alextomdog/3d-printer/docs/design.md

# 设计说明

## 1. 总体方案

这是一台 Cartesian 结构 FDM 打印机：X/Y 轴在水平面内运动，Z 轴带动热床升降。设计目标是使用 1515 铝型材、市售标准件和少量铝加工件，完成一台 220 × 220 mm 打印幅面的桌面机。

坐标定义沿用 BOM 中的约定：

- X：同一平面内两台 XY 步进电机连线的方向
- Y：同一平面内与 X 垂直的方向
- Z：垂直于水平面的方向

## 2. 框架

框架由 1515 铝型材组成：

| 长度 | 数量 | 位置 |
|---|---|---|
| 320 mm | 4 | Z 方向垂直支撑 |
| 285 mm | 4 | X 方向水平支撑 |
| 293 mm | 4 | Y 方向水平支撑 |
| 220 mm | 2 | 托盘 X 方向水平支撑 |
| 200 mm | 2 | 托盘 Y 方向水平支撑 |

型材之间用直角脚槽连接，配合 1515 T 型螺母与 M3 螺丝固定。框架的矩形度由 285/293 mm 两组横梁和角件共同保证。

## 3. XY 传动

- 动力：2 台 42-44 步进电机。
- 同步带：GT2-6，带宽 6 mm。
- 同步轮：2GT-20 齿、内孔 5 mm；主动轮 2 个，惰轮带齿 8 个、不带齿 2 个。
- 导向：MGN9 导轨，278 mm × 1 用于喷头移动，250 mm × 2 用于交叉方向；MGN9 标准滑块 3 个。

同步带轮固定在步进电机轴上，惰轮用于支撑和张紧皮带。喷头组件安装在 MGN9 滑块上，由 X 向同步带驱动。

## 4. 双 Z 与热床

- 动力：2 台 42-38 步进电机。
- 传动：T8 250 mm 丝杠 × 4，T8 法兰螺母 × 4；M5 转 M8 联轴器 × 2。
- 导向：M6 × 265 mm 光轴 × 4，SCS6UU 箱式滑块 × 4。
- 热床：MK3 铝基板热床 220 × 220 mm，200 × 200 mm 玻璃板，四角弹簧 + M3 螺丝调平。
- 测温：NTC 温度传感器。

双 Z 电机分别驱动左右丝杠，光轴与 SCS6UU 滑块承担侧向载荷。热床四边固定件与底部框架连接件把热床组件约束在 Z 托架上。

## 5. 挤出与喷头

- 热端：E3D V6 远程挤出头，1.75 mm 耗材、0.4 mm 喷嘴、12 V 40 W。
- 挤出机：MK8 远程挤出机，42-47 步进电机驱动。
- 安装：3D 打印 42 步进电机固定片、EV3 挤出头散热器固定块、火山喷头 V6 装配体。
- 导向：喷头安装在 MGN9 278 mm 导轨滑块上，配喷头限位器固定件与水平限位开关固定器。

## 6. 电控

- 主板：RAMPS 1.4 + Arduino Mega 2560。
- 驱动：5 × A4988，分别对应 X、Y、Z1、Z2、挤出机。
- 显示：2004 LCD。
- 电源：12 V 9 A。
- 传感器：NTC 热敏、X/Y/Z 限位开关。
- 热床与热端：MK3 热床、E3D V6 加热棒与风扇。

电气连接示意见 [`system-diagram.md`](system-diagram.md)。仓库不包含固件与引脚配置。

## 7. 加工与装配

- 15 张 DWG 加工图位于 `new_sw/cadFiles/`，覆盖框架连接件、热床固定件、同步带卡件、挤出机支架等。
- 铝加工件由外协加工，其余多为 3D 打印件或市售标准件。
- 主装配体为 `new_sw/打印机.SLDASM`；子装配体包括 `z-axis-with-slider.SLDASM`、`z-step-motor-conbination.SLDASM`、`火山喷头V6.SLDASM`、`MK8 Red Extruder Bowden.SLDASM` 等。

## 8. 设计边界

本项目完成结构、零件、装配、加工图与 BOM，不包含：

- Marlin 固件、引脚定义、PID/步进校准
- 切片参数、材料参数、打印测试
- 实物照片、装配视频、长期运行数据

因此仓库中的模型与图纸可用于复现结构设计，但不能直接证明整机已经制造或达到某个打印精度。
