alextomdog/3d-printer/THIRD_PARTY.md

# Third-Party Notices

本仓库的原创 CAD 模型、DWG 图纸、BOM 与文档采用 CERN-OHL-S-2.0（见 `LICENSE`）。以下标准件/厂商模型仅用于装配参考，版权归各自所有者，**不在本项目许可证覆盖范围内**：

| 名称 | 说明 |
|---|---|
| E3D V6 | 热端/喷头模型与规格，E3D 为其所有者 |
| MK8 Extruder | 挤出机模型，版权归原厂商 |
| MGN9 | 直线导轨与滑块，HIWIN 及相关厂商为其所有者 |
| RAMPS 1.4 | 开源硬件扩展板设计，版权归原作者 |
| A4988 | 步进驱动模块，Allegro 及相关厂商为其所有者 |
| Arduino Mega 2560 | 开发板，Arduino 为其所有者 |
| 42 步进电机 | 标准步进电机模型，版权归原厂商 |
| SCS6UU / 光轴 / T8 丝杠 / GT2 同步带 | 市售标准件，版权归各自厂商 |

本项目与上述厂商无隶属或背书关系。若你是权利人并认为某个模型不应出现在本仓库，请提交 issue，我们会移除相关文件。
