alextomdog/3d-printer/docs/bom.md

# BOM 摘要

原始 BOM 见仓库根目录 `material.xlsx` / `material.ods`。下表按功能分类整理规格与数量，**不包含采购价格、运费和商家信息**。

> 数量列保留 BOM 中的采购/备用量；部分紧固件按整包购买，实际装机数量小于采购数量。

## 1. 框架

| 物料 | 规格 | 数量 | 用途 |
|---|---|---|---|
| 1515 铝型材 | 320 mm | 4 | Z 方向垂直支撑 |
| 1515 铝型材 | 285 mm | 4 | X 方向水平支撑 |
| 1515 铝型材 | 293 mm | 4 | Y 方向水平支撑 |
| 1515 铝型材 | 220 mm | 2 | 托盘 X 方向水平支撑 |
| 1515 铝型材 | 200 mm | 2 | 托盘 Y 方向水平支撑 |
| 直角脚槽 | 1515 用 | 8 | 型材连接 |
| 1515 T 型螺母 | M3 | 100 | 型材固定 |

## 2. XY 传动与导向

| 物料 | 规格 | 数量 | 用途 |
|---|---|---|---|
| 42 步进电机 | 机身 44 mm | 2 | X/Y 轴驱动 |
| GT2-6 橡胶皮带 | 宽 6 mm，长 5 m | 1 | XY 传动 |
| 2GT-20 同步轮 | 20 齿，内孔 5 mm，带宽 6 mm | 2 | 电机与皮带连接 |
| 2GT-20 惰轮（带齿） | 20 齿，内孔 5 mm，带宽 6 mm | 8 | 皮带支撑/张紧 |
| 2GT-20 惰轮（不带齿） | 20 齿，内孔 5 mm，带宽 6 mm | 2 | 皮带支撑/张紧 |
| MGN9 导轨 | 278 mm | 1 | 喷头移动导向 |
| MGN9 导轨 | 250 mm | 2 | 交叉方向导向 |
| MGN9 标准滑块 | — | 3 | 配合导轨 |

## 3. Z 轴与热床

| 物料 | 规格 | 数量 | 用途 |
|---|---|---|---|
| 42 步进电机 | 机身 38 mm | 2 | 双 Z 驱动 |
| T8 丝杠 | 250 mm | 4 | Z 轴传动 |
| T8 丝杠法兰螺母 | 内径 8 mm | 4 | 丝杠螺母 |
| 联轴器 | M5 转 M8 | 2 | Z 电机与丝杠连接 |
| 光轴 | M6 × 265 mm | 4 | Z 轴导向 |
| SCS6UU 箱式滑块 | 内径 6 mm | 4 | 光轴滑动 |
| MK3 铝基板热床 | 220 × 220 mm | 1 | 加热平台 |
| 玻璃板 | 200 × 200 mm | 1 | 打印面 |
| 热床弹簧 | — | 4 | 四角调平 |
| NTC 温度传感器 | — | 1 | 热床测温 |
| 高温胶带 | — | 1 | 热床绝缘/固定 |

## 4. 挤出与喷头

| 物料 | 规格 | 数量 | 用途 |
|---|---|---|---|
| 42 步进电机 | 机身 47 mm | 1 | 挤出机驱动 |
| E3D V6 远程挤出头 | 1.75 mm / 0.4 mm，12 V 40 W | 1 | 熔融挤出 |
| MK8 挤出机 | — | 1 | 耗材输送 |
| 3D 打印 42 步进电机固定片 | — | 1 | 卧式固定挤出机 |
| EV3 挤出头散热器固定块 | — | 1 | 固定远程挤出头 |
| 火山喷头 V6 装配体 | — | 1 | 喷头组件 |

## 5. 电控

| 物料 | 规格 | 数量 | 用途 |
|---|---|---|---|
| RAMPS 1.4 扩展板 | Mega 2560 接口 | 1 | 步进电机与外围接口 |
| Arduino Mega 2560 | — | 1 | 主控 |
| A4988 步进驱动模块 | 红色 | 5 | X/Y/Z1/Z2/E 驱动 |
| 2004 LCD | — | 1 | 状态显示与控制 |
| 12 V 9 A 电源 | 实测约 12.4 V / 9.3 A | 1 | 整机供电 |
| 限位开关 | — | 3 | X/Y/Z 回零 |

## 6. 紧固件与加工件

| 物料 | 规格 | 数量 | 用途 |
|---|---|---|---|
| M3 × 6 螺丝 | — | 150（采购量） | 框架/零件固定 |
| M3 × 18 螺丝 | — | 50（采购量） | 升降台固定 |
| M3 × 15 螺丝 | — | 50（采购量） | 火山喷头铝片固定 |
| M3 × 35 螺丝 | — | 50（采购量） | 火山喷头下部固定 |
| M5 × 45 螺丝 | — | 20（采购量） | 同步轮固定 |
| M3 螺母 | — | 100（采购量） | 紧固 |
| M5 螺母 | — | 100（采购量） | 紧固 |
| M5 × 10 × 1 垫片 | — | 100（采购量） | 紧固 |
| M3 × 8 × 0.5 垫片 | — | 100（采购量） | 紧固 |
| 铝加工零件 | 按 DWG 加工 | 1 批 | 框架连接、热床固定、同步带卡件、挤出机支架等 |

## 7. 图纸

`new_sw/cadFiles/` 下共 15 张 DWG，主要包括：

- 42 步进电机固定片（XY）
- 侧板、顶板、底板、总装图
- Z 光轴固定
- 同步带卡住零件
- 挤出机支架固定片
- 法兰螺母-热床连接
- 滑动连接器 XY
- 热床四边固定
- 热床底部框架连接
- 边角固定
- 边角支架固定 H 型惰轮
