alextomdog/3d-printer/material.ods

材料 | 数量 | 作用 | 购买价格 | 备注 | 定义X方向为在同一平面内，两个步进电机连线的方向
1515铝型材 | 长320mm x 4 | 作为4个z轴方向上的垂直支撑 | 48 | 运费15 | 定义y方向为在同一平面内，两个步进电机连线的方向的垂直的方向
1515铝型材 | 长285mm x 4 | 作为4个x轴方向上的水平支撑 |  |  | 定义z方向为垂直于水平面的方向
1515铝型材 | 长293mm x 4 | 作为4个y轴方向上的水平支撑
1515铝型材 | 长220mm x 2 | 作为2个x轴方向上的托盘水平支撑 |  |  | 726.54
1515铝型材 | 长200mm x 2 | 作为2个y轴方向上的托盘水平支撑
光轴 | M6长265mm x 4 | 作为运动体系的滑动支撑（z轴） | 16.8
联轴器5转8 | （M5转M8）x 2 | 用来连接z轴方向上步进电机（M5）和丝杠（M8） | 5.44
T8型螺杆（丝杠） | 长250mm x 4 | 通过步进电机用来控制托盘z轴方向的运动 | 32.87
T8丝杠法兰螺母 | 内径8mm x 4 | 作为T8型丝杠的螺母
42步进电机 | （身长47）x 1 | 用来作为高速打印挤出机（挤出打印材料） | 76.3
42步进电机 | （身长44）x 2 | 用来控制xy轴方向上的移动
42步进电机 | （身长38）x 2 | 作为双z轴，用来控制z轴方向上的移动
12V9A电源 | x 1（实际12.4V9.3A12.3欧） | 用来给整台机器供电 | 16.8
scs6uu箱式滑块 | X 4 | z轴光轴滑动固定 | 18.22
GT2-6橡胶皮带 | （长度5m，皮带厚6mm）x 1 | 用来作为传动装置 | 14.51
2GT-20齿内孔5mm同步轮 | （皮带带6mm20齿内孔5mm）x 2 | 用来作为连接皮带和xy轴步进电机的连接装置 | 6.26
2GT-20齿内孔5mm同步轮（惰轮）带齿 | （20齿内孔5带宽6）带齿 x 8 | 用来辅助支撑皮带传动 | 42.75
2GT-20齿内孔5mm同步轮（惰轮）不带齿 | （20齿内孔5带宽6）不带齿 x 2 | 用来辅助支撑皮带传动
RAMPS 1.4 mega 2560扩展版 | X 1 | 用来扩展arduino mega的接口，连接步进电机 | 16.8
2004液晶控制屏幕 | X 1 | 连接ramps，用来显示数据 | 26.21
A4998步进电机驱动模块 | （红色）x 5 | 驱动步进电机 | 21.5
直角脚槽 | X 8 | 用来连接1515铝框架 | 9.9
Arduino Mega2560 | x1 | 单片机控制电路板 | 0
E3D-v6远程挤出头 | （1.75/0.4MM 12v 40w) x1 | 用于挤出材料 | 19.8
MK8-挤出机 | X 1 | 用于传送材料 | 16.8
3D打印42步进电机固定片 | X 1 | 卧式用来固定挤出机 | 2.7
EV3挤出头散热器固定块 | X 1 | 固定远程挤出头 | 12.87
MGN9滑轨长度278 | X 1 | 用来作为喷出头的移动滑轨 | 68.89
MGN9滑轨长度250 | X 2 | 作为交叉方向的移动滑轨
MGN9标准滑块 | X 3 | 配合滑轨一起使用
铝加工零件 | X 1 | 配合各种零件 | 110
M3*6螺丝 | X 56 + 16 + 24 + 6 + 28 → 150 | 整体框架固定 | 13.4
M3*18螺丝 | X 4 → 50 | 升降台固定 | 5.6
M3 * 15 | X 4 → 50 | 火山喷出头铝片固定 | 4.97
M3 * 35 | X 4 → 50 | 火山喷出头下面固定 | 6
M5 * 45 | X 6 → 20 | 用于同步轮固定 | 5.4
M3螺母 | X 10 → 100 |  | 2.06
1515T型螺母M3 | X 100 | 固定 | 25
M5螺母 | X 100 |  | 4.92
M5 * 10 * 1垫片 | X 100 |  | 4.28
M3 * 8 * 0.5 | X 100 |  | 3.76
3d打印机弹簧 | x4 |  | 7.93
高温胶带 | x1 |  | 4.6
NTC温度传感器 | X 1 |  | 4.3
MK3铝基板热床 | x1 |  | 29.3
玻璃板200x200 | X 1 |  | 12.8
3d设计partdatamanager | X 1 | 零件生成 | 8.8
