alextomdog/3d-printer/new_sw/打印机.SLDASM

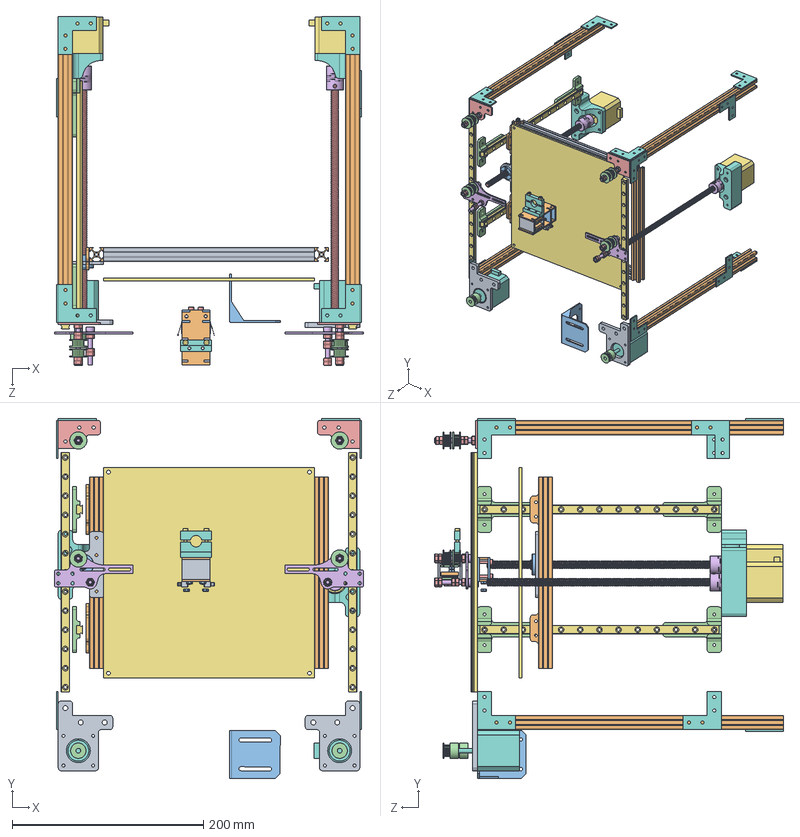
[picture p1: CAD file, 2023-12-28]
new_sw/打印机.SLDASM
323.2 x 376.0 x 365.0 mm
42-步进电机固定片-xy x 2
step-motor-44 x 2
MGN9滑轨 x 4
滑动连接器xy x 2
边角支架固定H型号惰轮 x 2
H型号惰轮20齿带宽6内孔5厚度85带齿 x 8
挤出机固定座支架
E3dV6挤出火山头固定块Ender3系列
GB／T70．1-2000内六角圆柱头螺钉M3×16-火山喷出头 x 2
GB／T70．1-2000内六角圆柱头螺钉M5×35 x 4
M5螺母8-5-3_9 x 24
同步带轮20齿带宽6内孔5厚度85带齿 x 2
bottom2 x 2
asside x 2
top1 x 2
边角固定 x 14
heatedBed热床220x220
GB／T70．1-2000内六角圆柱头螺钉M5×45 x 2
GB／T70．1-2000内六角圆柱头螺钉M3×15 x 4
同步带卡住零件 x 2
M3螺母 x 10
同步带卡住零件 one-side x 2
限位开关 x 2
fixSteperPanel x 2
step-motor-38 x 2
cr-5-8联轴器 x 2
tr8丝杠z轴 x 2
rail_slider_1515_connection x 4
tr8法兰螺母
滑块-热床 x 2
丝杠法兰螺母-热床
