alextomdog/3d-printer/new_sw/vocano/cocano_asemably.SLDASM

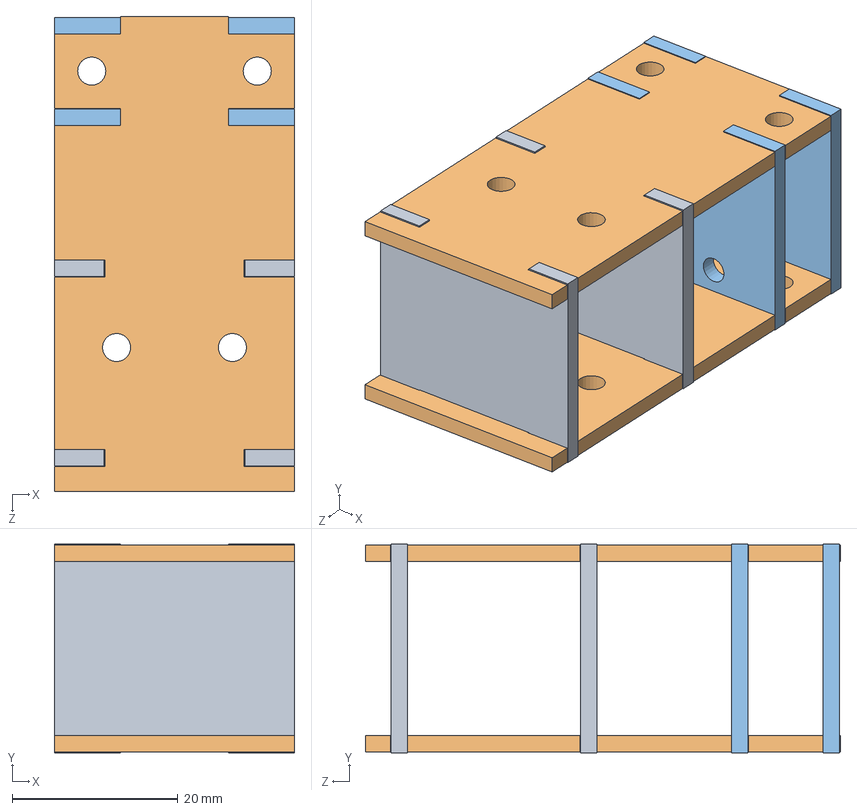
[picture p2: CAD file, 2023-12-27]
new_sw/vocano/cocano_asemably.SLDASM
29.0 x 25.2 x 57.4 mm
bottom2 x 2
asside x 2
top1 x 2
