alextomdog/3d-printer/new_sw/z-axis-with-slider.SLDASM

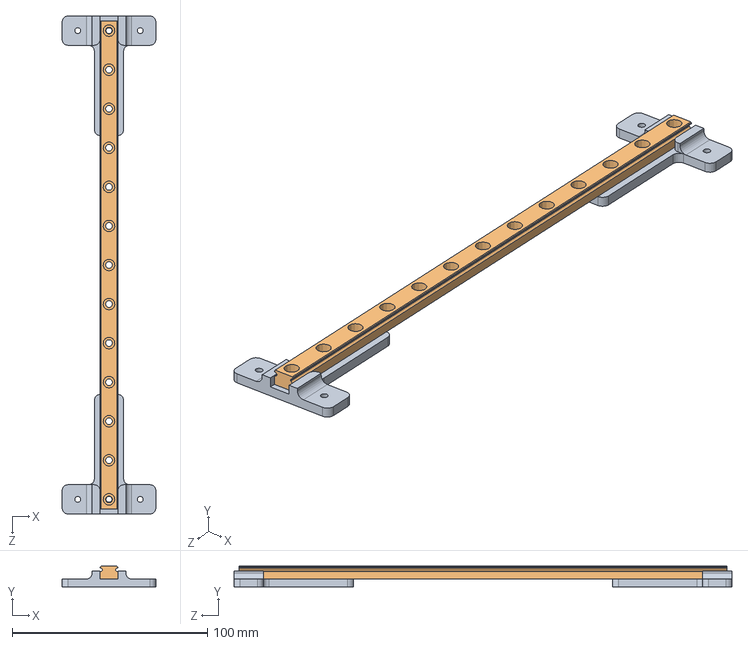
[picture p3: CAD file, 2023-12-28]
new_sw/z-axis-with-slider.SLDASM
48.0 x 10.5 x 255.0 mm
MGN9滑轨
rail_slider_1515_connection x 2
