alextomdog/3d-printer/new_sw/z-step-motor-conbination.SLDASM

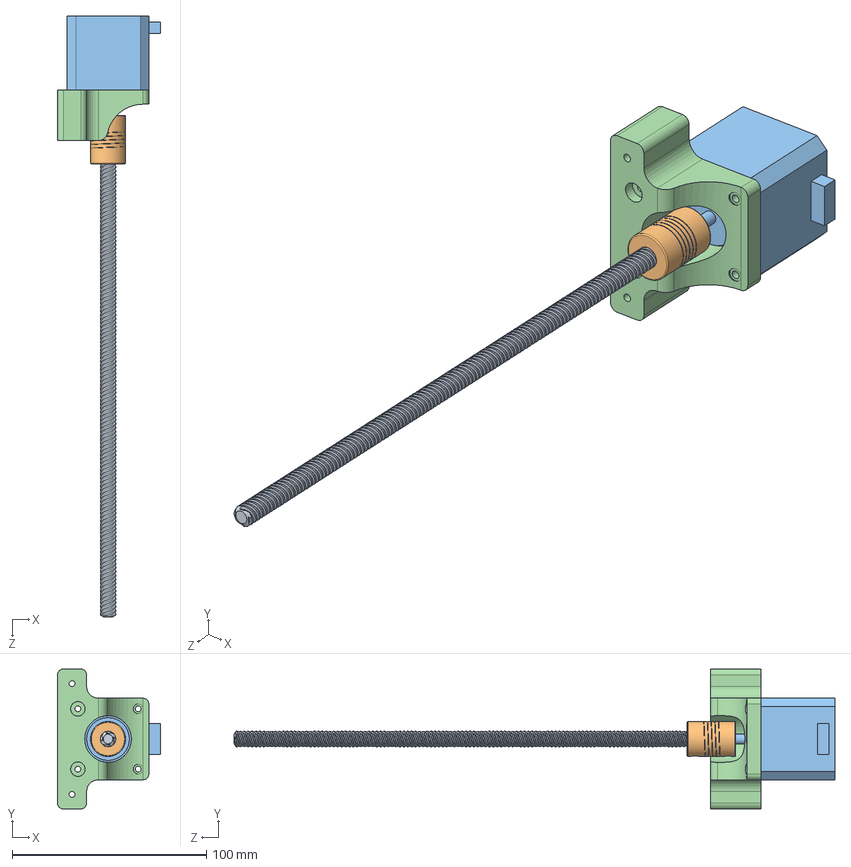
[picture p4: CAD file, 2023-12-27]
new_sw/z-step-motor-conbination.SLDASM
53.0 x 72.0 x 309.0 mm
fixSteperPanel
step-motor-38
cr-5-8联轴器
tr8丝杠z轴
