alextomdog/3d-printer/new_sw/火山喷头限位开关固定装配体.SLDASM

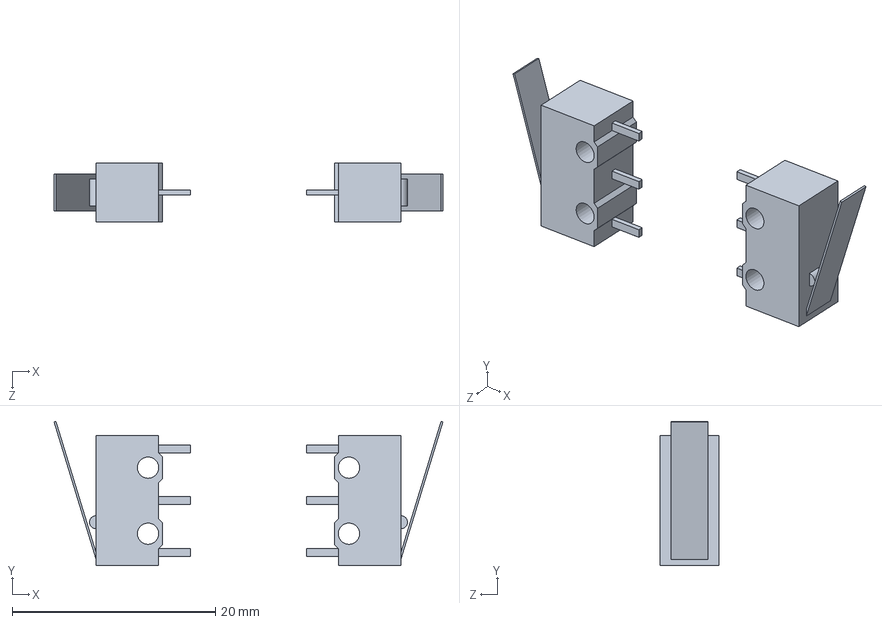
[picture p5: CAD file, 2023-12-27]
new_sw/火山喷头限位开关固定装配体.SLDASM
38.3 x 14.2 x 5.80 mm
限位开关 x 2
