alextomdog/3d-printer/new_sw/vocano/top1.SLDPRT

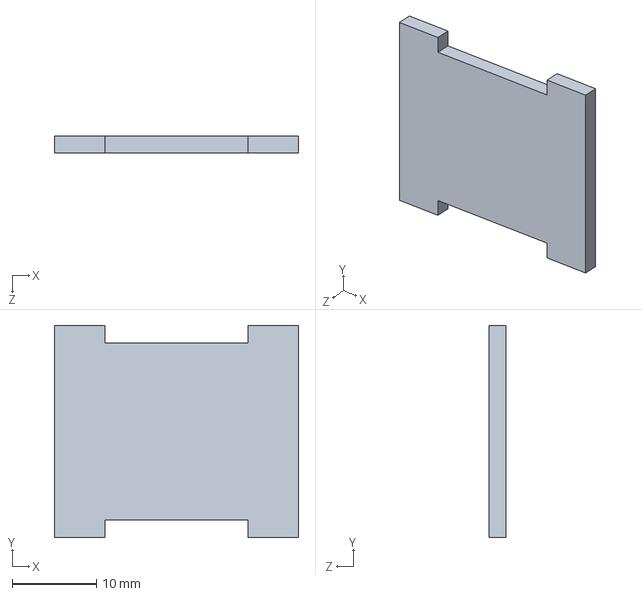
[picture p6: CAD file, 2023-12-27]
new_sw/vocano/top1.SLDPRT
29.0 x 25.2 x 2.00 mm
