alextomdog/3d-printer/new_sw/丝杠法兰螺母-热床.SLDPRT

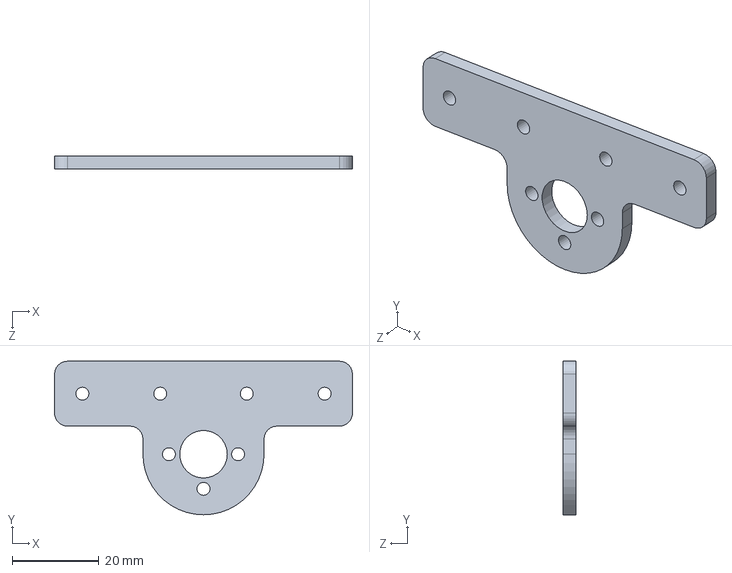
[picture p7: CAD file, 2023-12-28]
new_sw/丝杠法兰螺母-热床.SLDPRT
68.9 x 35.5 x 3.00 mm
