alextomdog/3d-printer/new_sw/vocano/aside_another.SLDPRT

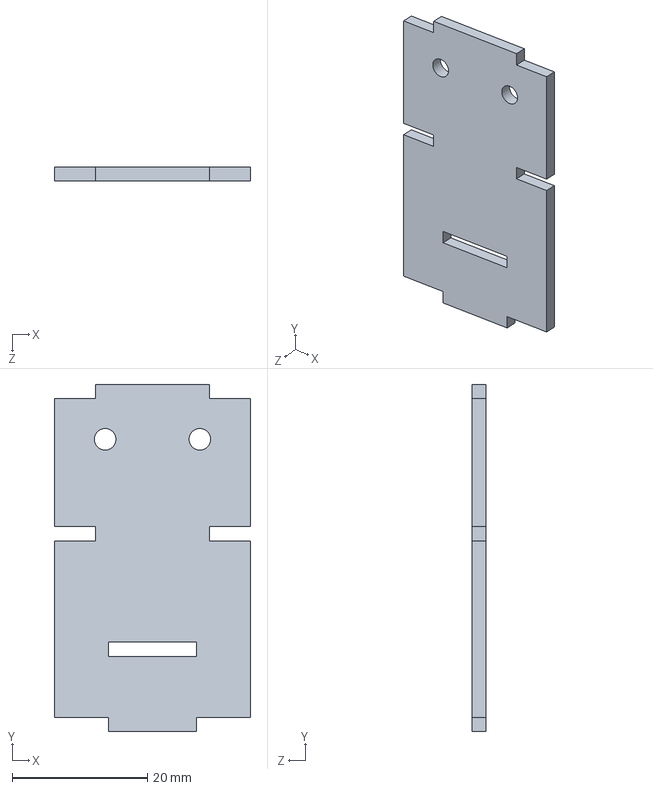
[picture p8: CAD file, 2023-12-27]
new_sw/vocano/aside_another.SLDPRT
29.0 x 51.3 x 2.00 mm
