alextomdog/3d-printer/new_sw/滑块-热床.SLDPRT

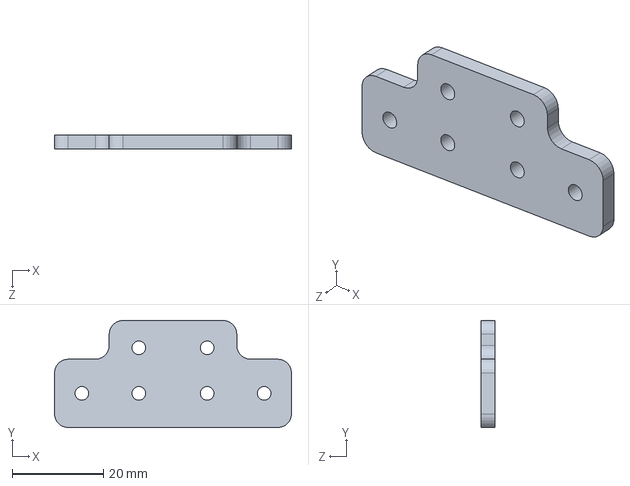
[picture p9: CAD file, 2023-12-28]
new_sw/滑块-热床.SLDPRT
52.0 x 23.5 x 3.00 mm
