alextomdog/3d-printer/new_sw/rail_slider_1515_connection.SLDPRT

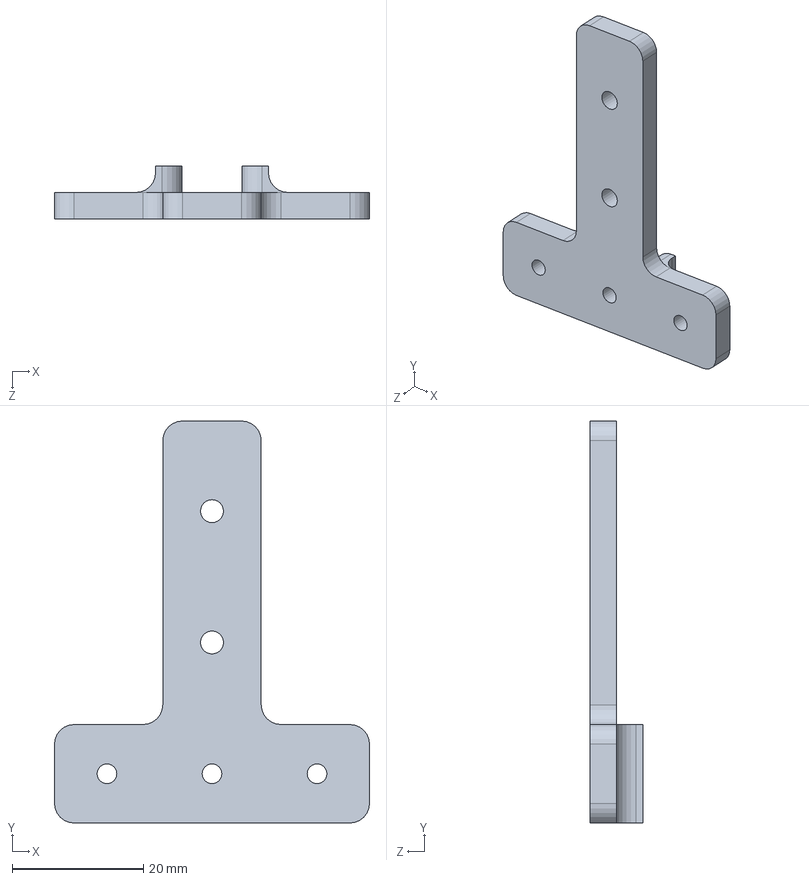
[picture p10: CAD file, 2023-12-28]
new_sw/rail_slider_1515_connection.SLDPRT
48.0 x 61.2 x 8.00 mm
