alextomdog/3d-printer/new_sw/vocano/asside.SLDPRT

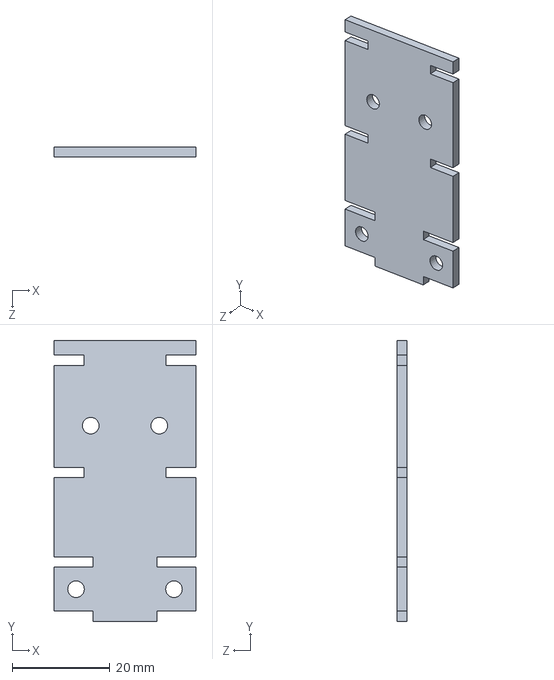
[picture p11: CAD file, 2023-12-27]
new_sw/vocano/asside.SLDPRT
29.0 x 57.4 x 2.00 mm
