alextomdog/3d-printer/new_sw/step-motor-44.SLDPRT

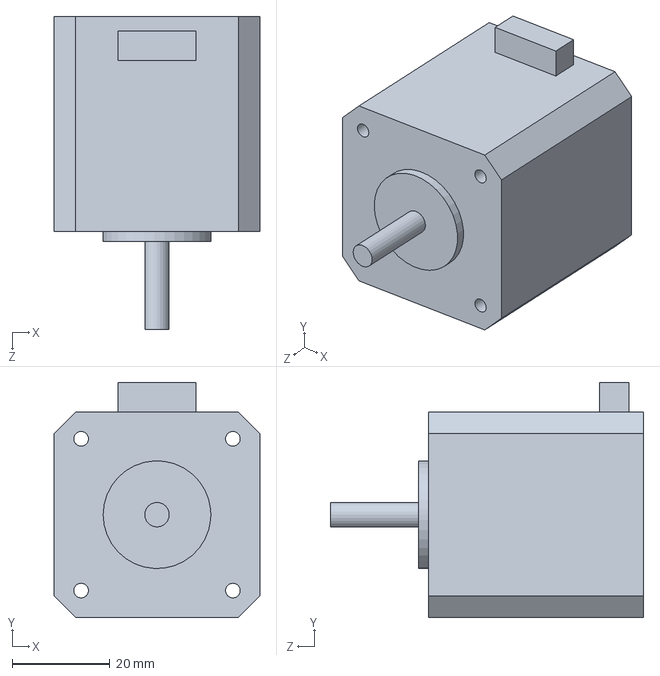
[picture p12: CAD file, 2023-12-27]
new_sw/step-motor-44.SLDPRT
42.0 x 48.0 x 64.0 mm
