alextomdog/3d-printer/new_sw/1515-220.SLDPRT

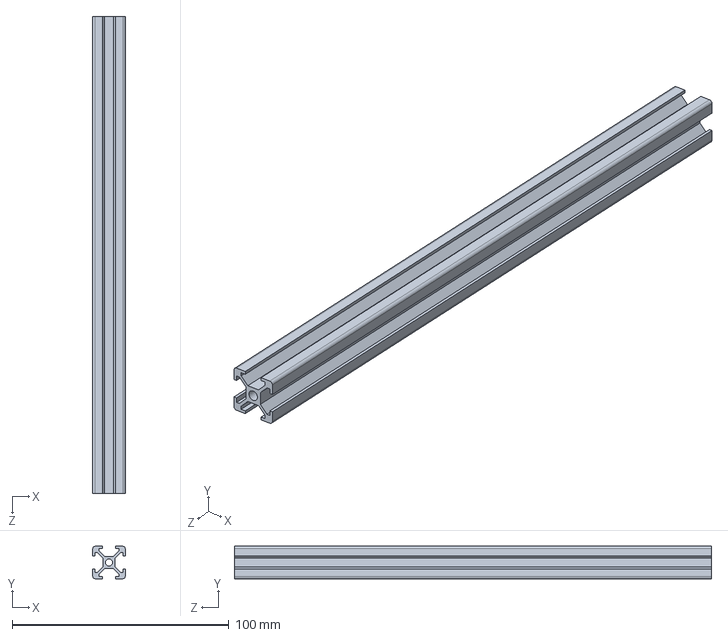
[picture p14: CAD file, 2023-12-27]
new_sw/1515-220.SLDPRT
15.0 x 15.0 x 220.0 mm
