alextomdog/3d-printer/new_sw/限位开关.SLDPRT

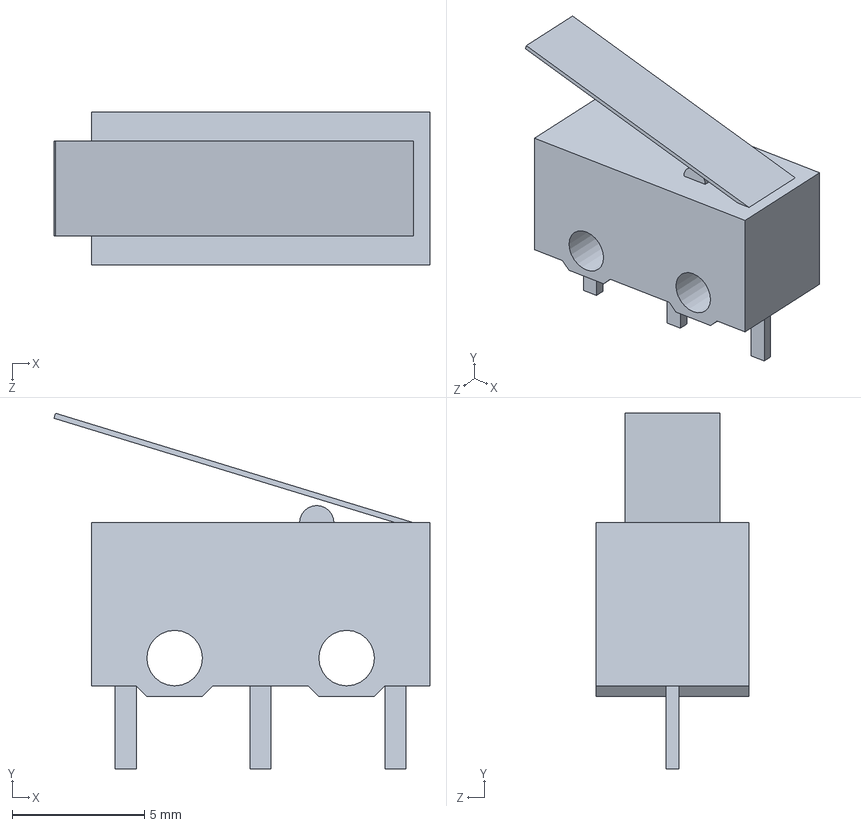
[picture p15: CAD file, 2023-12-27]
new_sw/限位开关.SLDPRT
14.2 x 13.4 x 5.80 mm
