alextomdog/3d-printer/new_sw/MGN9滑轨.SLDPRT

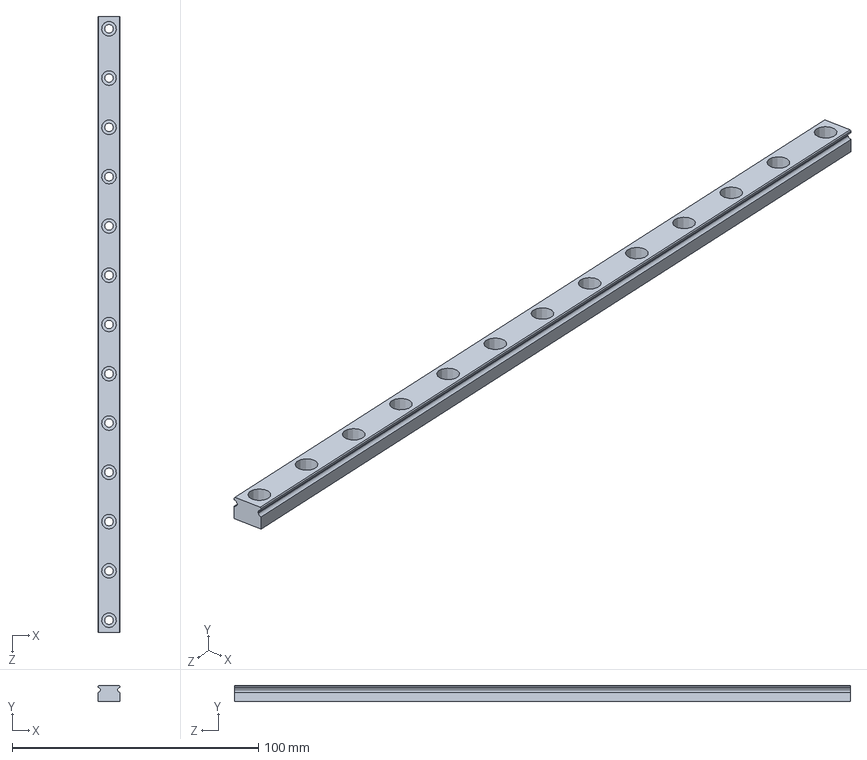
[picture p16: CAD file, 2023-12-27]
new_sw/MGN9滑轨.SLDPRT
9.00 x 6.50 x 250.0 mm
