alextomdog/3d-printer/new_sw/同步带卡住零件.SLDPRT

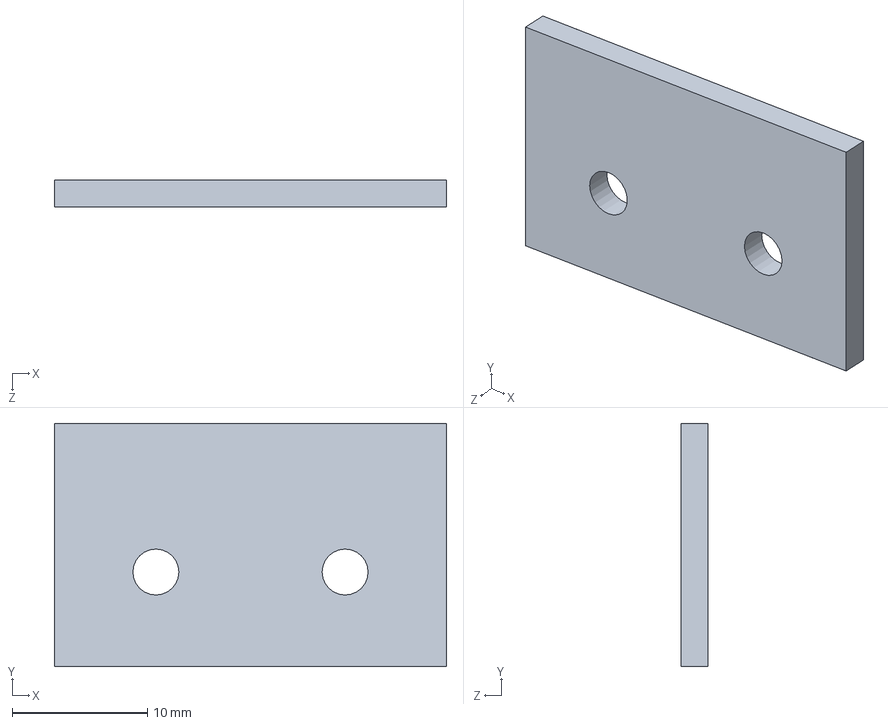
[picture p17: CAD file, 2023-12-27]
new_sw/同步带卡住零件.SLDPRT
29.0 x 18.0 x 2.00 mm
