alextomdog/3d-printer/new_sw/GB／T70．1-2000内六角圆柱头螺钉M5×35.SLDPRT

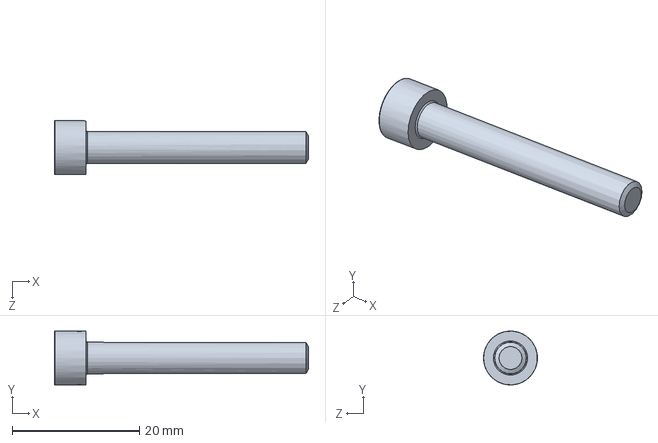
[picture p18: CAD file, 2023-12-27]
new_sw/GB／T70．1-2000内六角圆柱头螺钉M5×35.SLDPRT
40.0 x 8.48 x 8.50 mm
