alextomdog/3d-printer/new_sw/挤出机固定座支架.SLDPRT

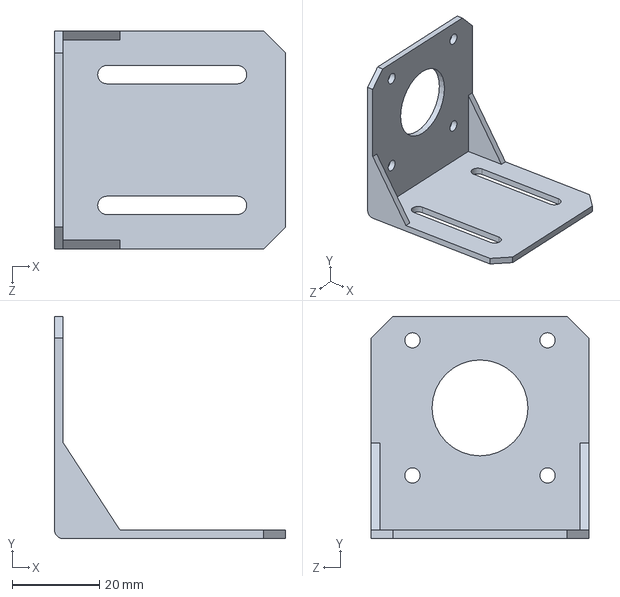
[picture p19: CAD file, 2023-12-27]
new_sw/挤出机固定座支架.SLDPRT
53.0 x 51.0 x 50.0 mm
