alextomdog/3d-printer/new_sw/同步带轮20齿带宽6内孔5厚度85带齿.SLDPRT

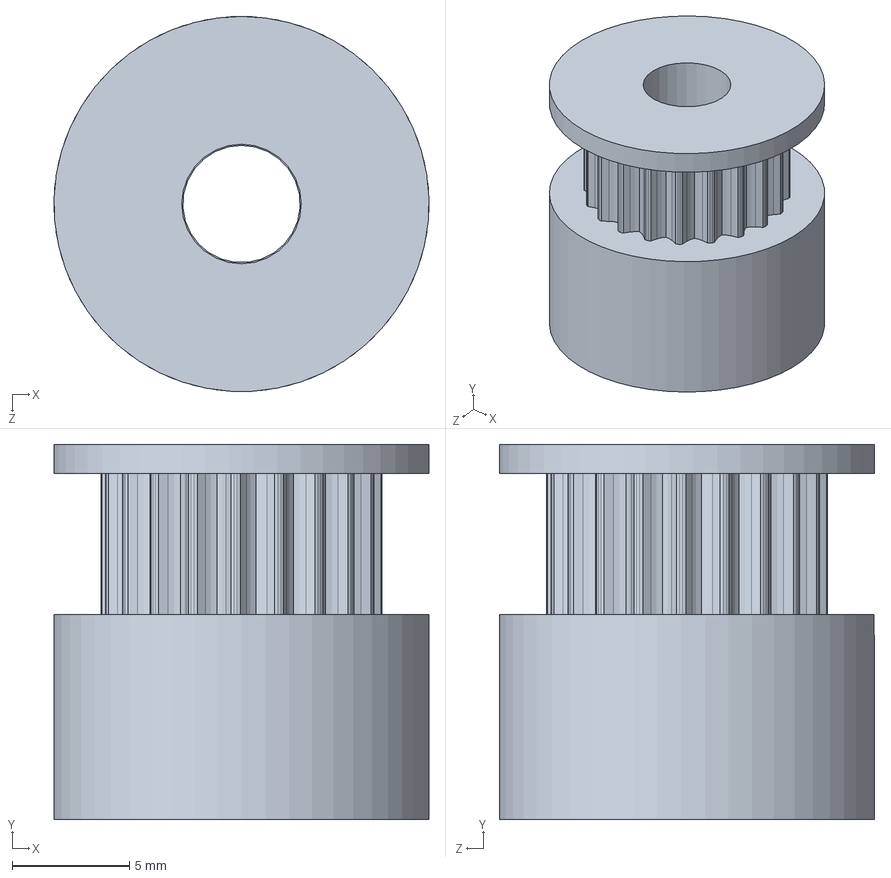
[picture p20: CAD file, 2023-12-27]
new_sw/同步带轮20齿带宽6内孔5厚度85带齿.SLDPRT
16.0 x 16.0 x 16.0 mm
