alextomdog/3d-printer/new_sw/SCS6UU.SLDPRT

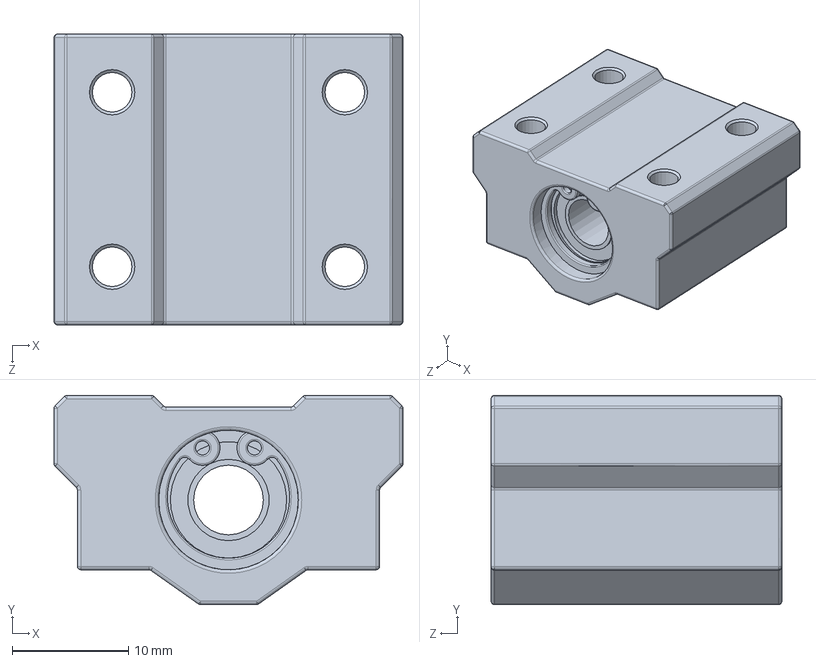
[picture p21: CAD file, 2023-12-27]
new_sw/SCS6UU.SLDPRT
30.0 x 18.0 x 25.0 mm
