alextomdog/3d-printer/new_sw/GB／T70．1-2000内六角圆柱头螺钉M3×12-火山头喷出.SLDPRT

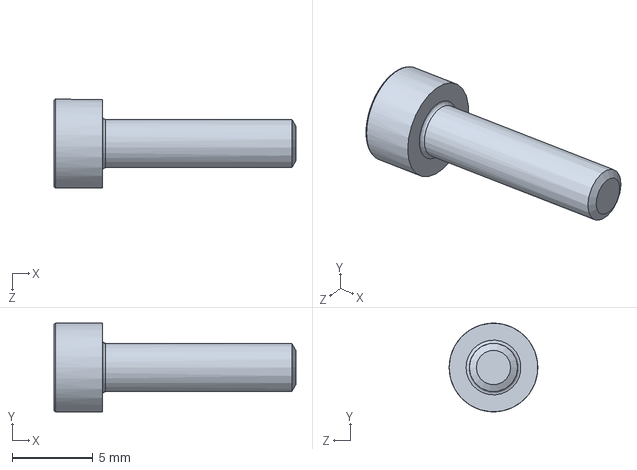
[picture p22: CAD file, 2023-12-27]
new_sw/GB／T70．1-2000内六角圆柱头螺钉M3×12-火山头喷出.SLDPRT
15.0 x 5.49 x 5.50 mm
