alextomdog/3d-printer/new_sw/tr8法兰螺母.SLDPRT

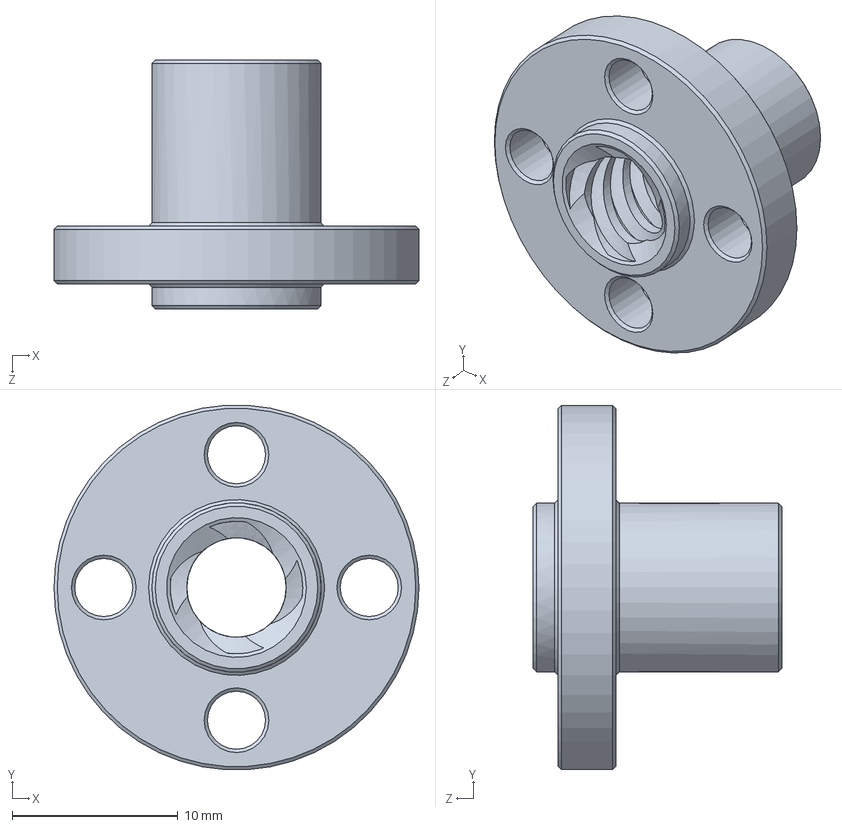
[picture p23: CAD file, 2023-12-27]
new_sw/tr8法兰螺母.SLDPRT
22.0 x 22.0 x 15.0 mm
