alextomdog/3d-printer/new_sw/同步带卡住零件 one-side.SLDPRT

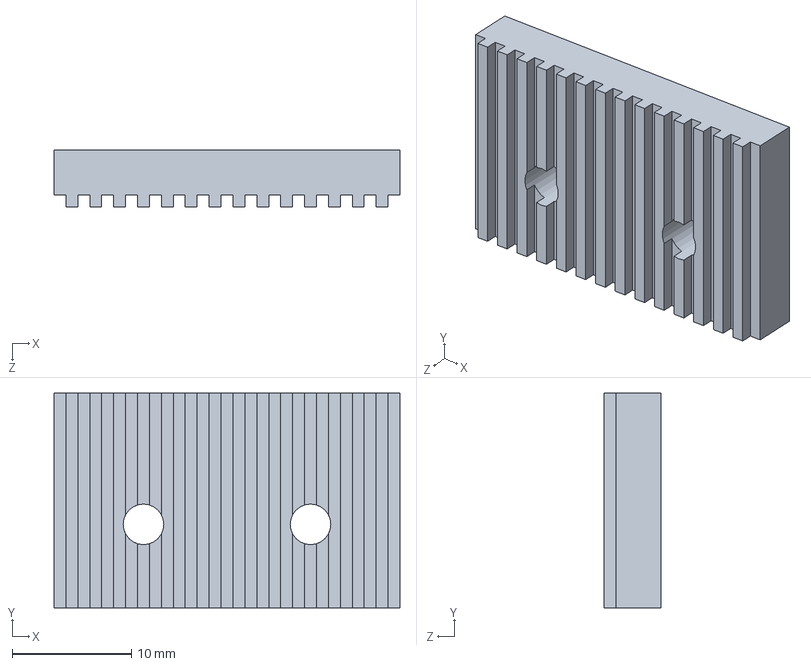
[picture p24: CAD file, 2023-12-27]
new_sw/同步带卡住零件 one-side.SLDPRT
29.0 x 18.0 x 4.80 mm
