alextomdog/3d-printer/new_sw/水平限位开关固定器.SLDPRT

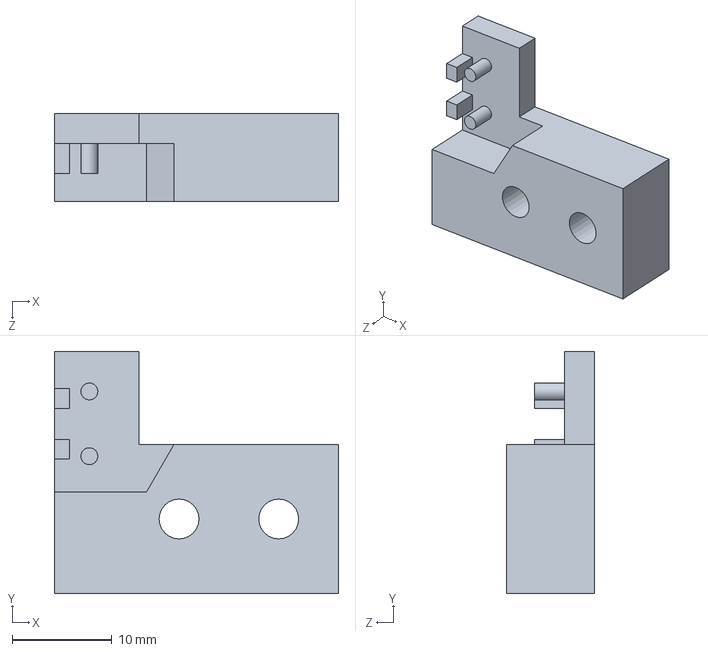
[picture p25: CAD file, 2023-12-27]
new_sw/水平限位开关固定器.SLDPRT
28.5 x 24.3 x 8.80 mm
