alextomdog/3d-printer/new_sw/边角支架固定H型号惰轮.SLDPRT

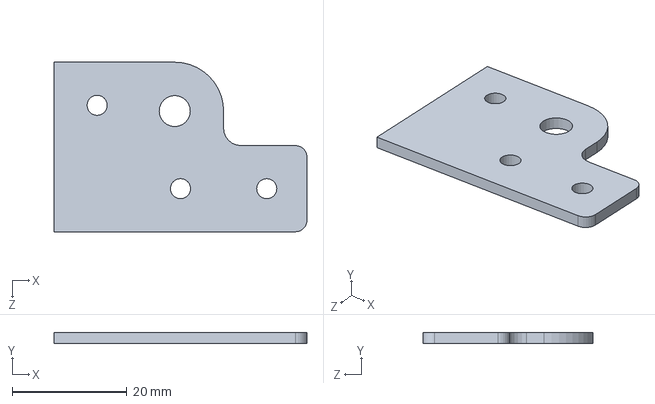
[picture p26: CAD file, 2023-12-27]
new_sw/边角支架固定H型号惰轮.SLDPRT
44.0 x 2.00 x 29.5 mm
