alextomdog/3d-printer/new_sw/E3dV6挤出火山头固定块Ender3系列.SLDPRT

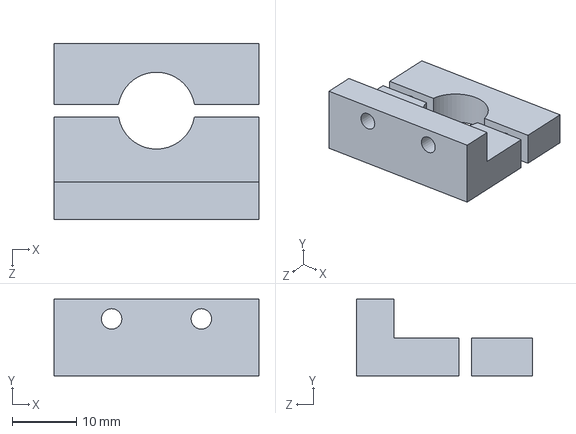
[picture p27: CAD file, 2023-12-27]
new_sw/E3dV6挤出火山头固定块Ender3系列.SLDPRT
32.0 x 12.0 x 27.5 mm
