alextomdog/3d-printer/new_sw/滑动连接器xy.SLDPRT

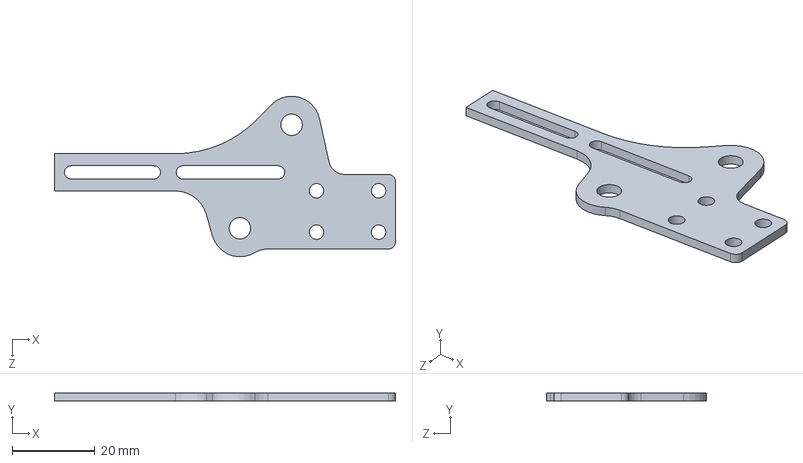
[picture p28: CAD file, 2023-12-27]
new_sw/滑动连接器xy.SLDPRT
82.4 x 2.00 x 38.8 mm
