alextomdog/3d-printer/new_sw/GB／T70．1-2000内六角圆柱头螺钉M5×45.SLDPRT

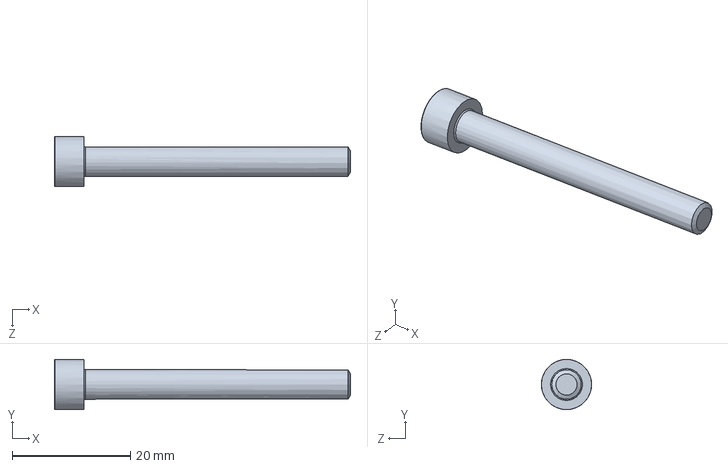
[picture p29: CAD file, 2023-12-27]
new_sw/GB／T70．1-2000内六角圆柱头螺钉M5×45.SLDPRT
50.0 x 8.50 x 8.50 mm
