alextomdog/3d-printer/new_sw/cr-5-8联轴器.SLDPRT

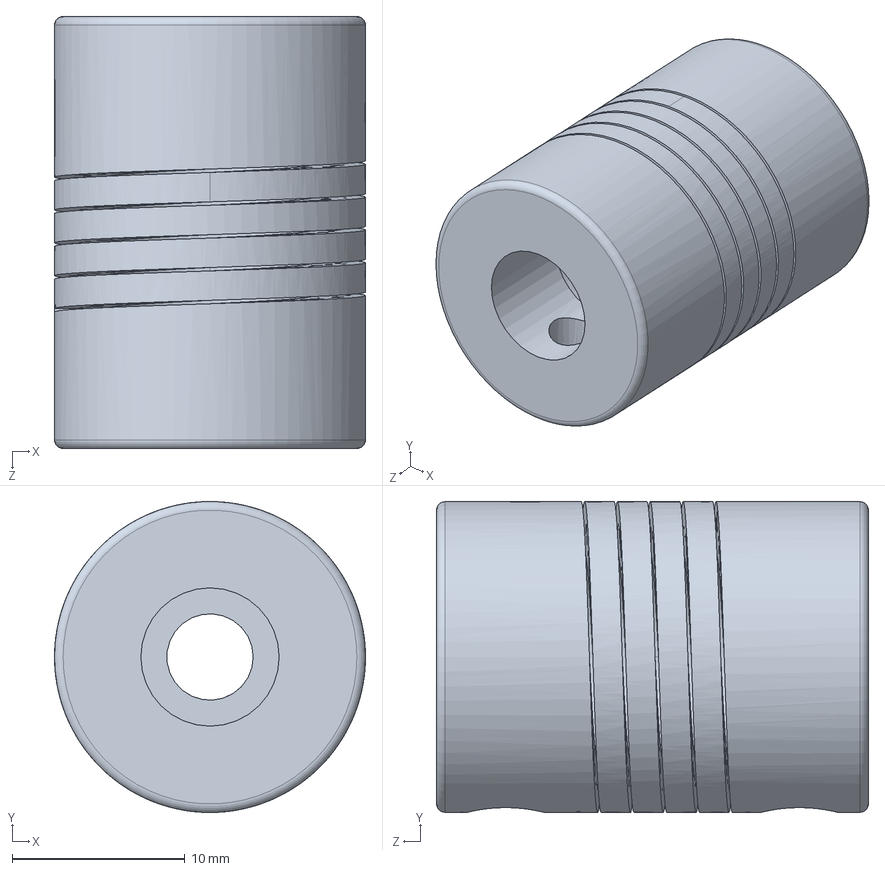
[picture p30: CAD file, 2023-12-27]
new_sw/cr-5-8联轴器.SLDPRT
18.0 x 18.0 x 25.0 mm
