alextomdog/3d-printer/new_sw/1515-200.SLDPRT

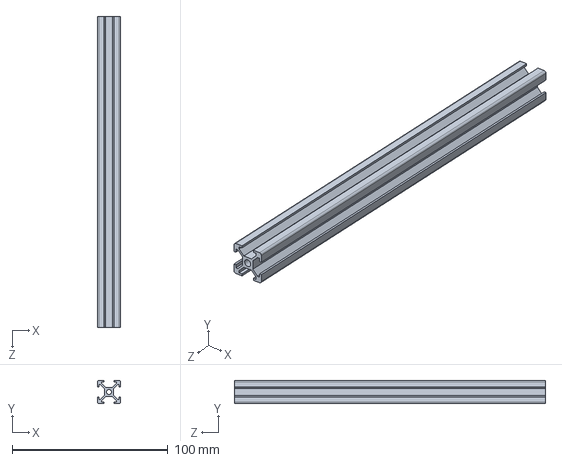
[picture p31: CAD file, 2023-12-27]
new_sw/1515-200.SLDPRT
15.0 x 15.0 x 200.0 mm
