alextomdog/3d-printer/new_sw/GB／T70．1-2000内六角圆柱头螺钉M3×15.SLDPRT

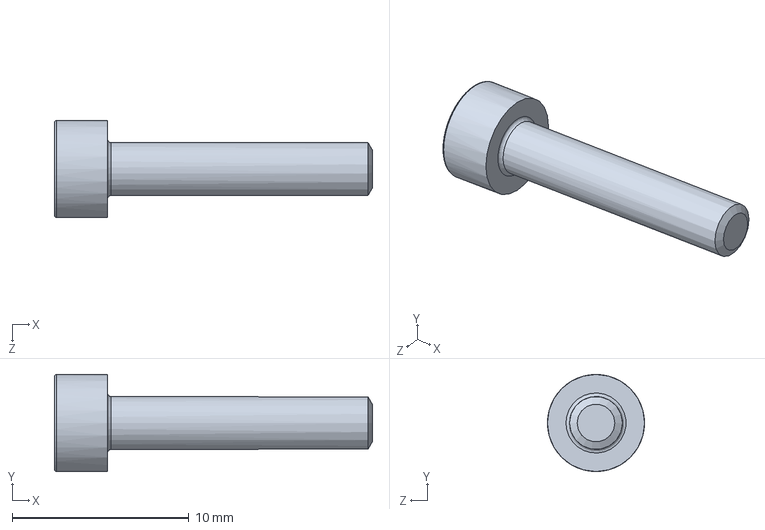
[picture p32: CAD file, 2023-12-27]
new_sw/GB／T70．1-2000内六角圆柱头螺钉M3×15.SLDPRT
18.0 x 5.50 x 5.50 mm
