alextomdog/3d-printer/new_sw/M5螺母8-5-3_9.SLDPRT

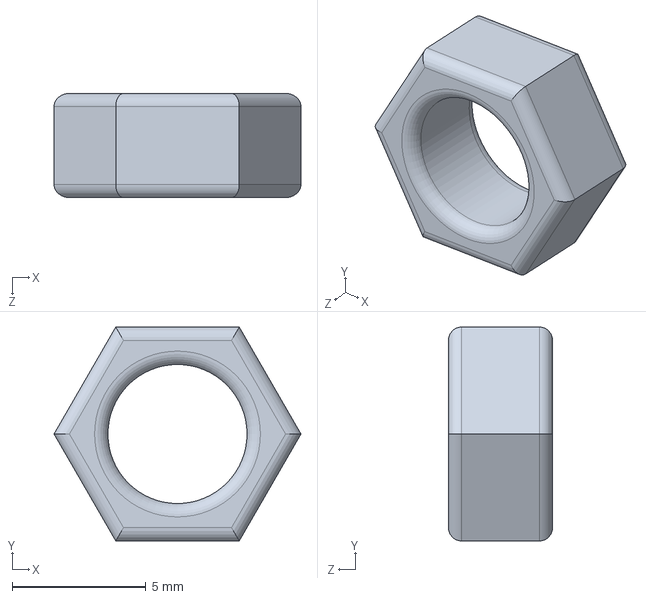
[picture p33: CAD file, 2023-12-27]
new_sw/M5螺母8-5-3_9.SLDPRT
9.24 x 8.00 x 3.90 mm
