alextomdog/3d-printer/new_sw/heatedBed热床220x220.SLDPRT

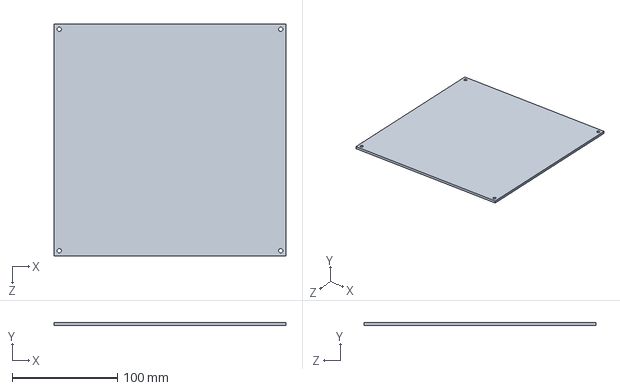
[picture p34: CAD file, 2023-12-27]
new_sw/heatedBed热床220x220.SLDPRT
220.0 x 3.00 x 220.0 mm
