alextomdog/3d-printer/new_sw/H型号惰轮20齿带宽6内孔5厚度85带齿.SLDPRT

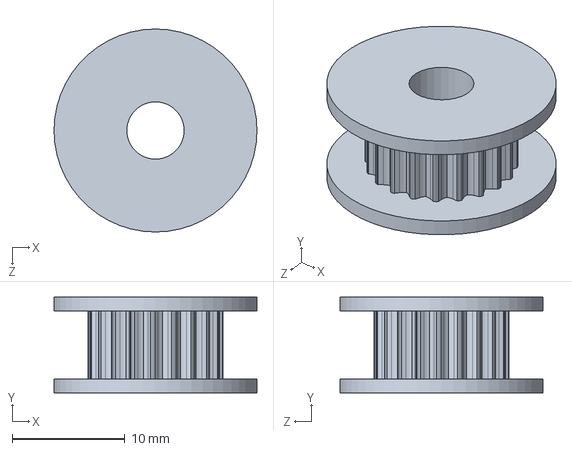
[picture p35: CAD file, 2023-12-27]
new_sw/H型号惰轮20齿带宽6内孔5厚度85带齿.SLDPRT
18.0 x 8.50 x 18.0 mm
