alextomdog/3d-printer/new_sw/M3螺母.SLDPRT

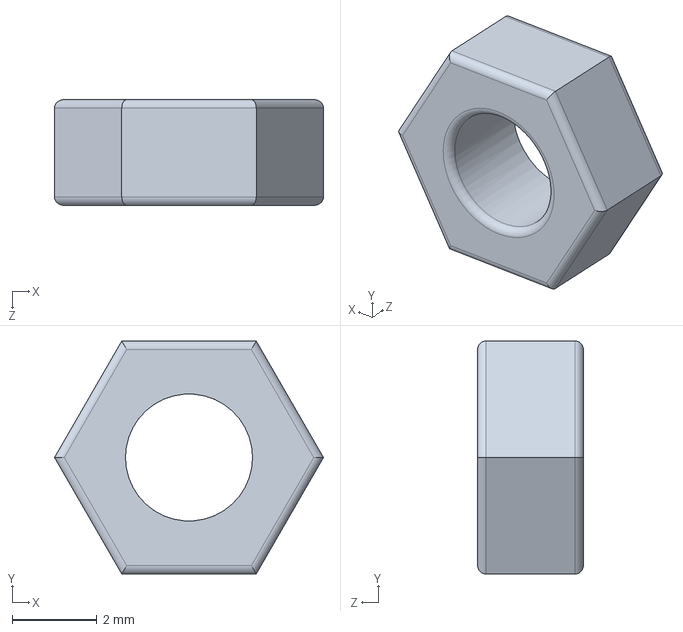
[picture p36: CAD file, 2023-12-27]
new_sw/M3螺母.SLDPRT
6.35 x 5.50 x 2.50 mm
