alextomdog/3d-printer/new_sw/step-motor-38.SLDPRT

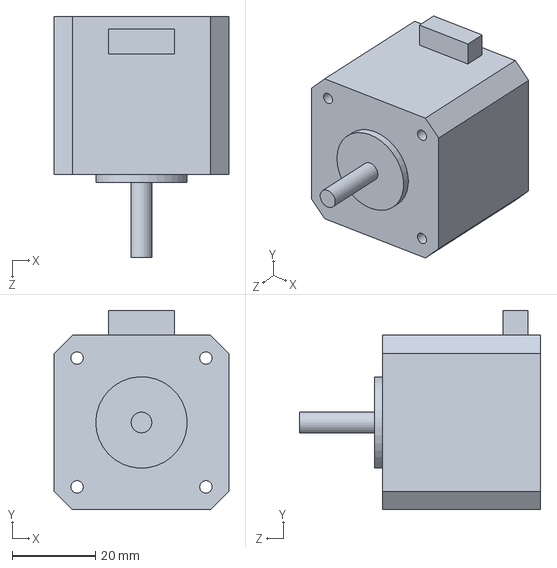
[picture p37: CAD file, 2023-12-27]
new_sw/step-motor-38.SLDPRT
42.0 x 48.0 x 58.0 mm
