alextomdog/3d-printer/new_sw/42-步进电机固定片-xy.SLDPRT

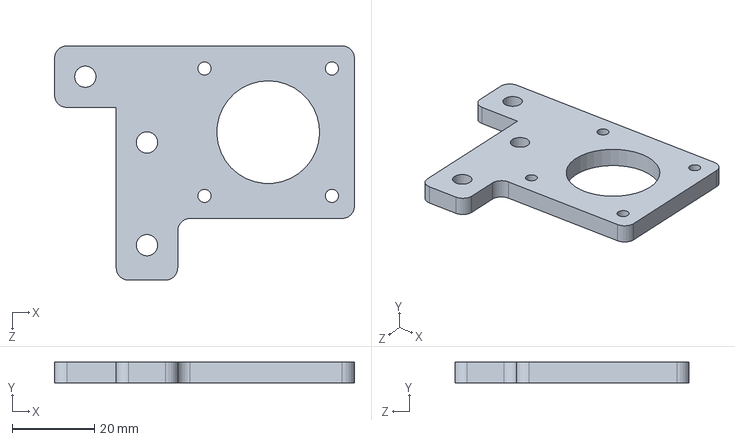
[picture p38: CAD file, 2023-12-27]
new_sw/42-步进电机固定片-xy.SLDPRT
73.0 x 5.00 x 57.0 mm
