alextomdog/3d-printer/new_sw/tr8丝杠z轴.SLDPRT

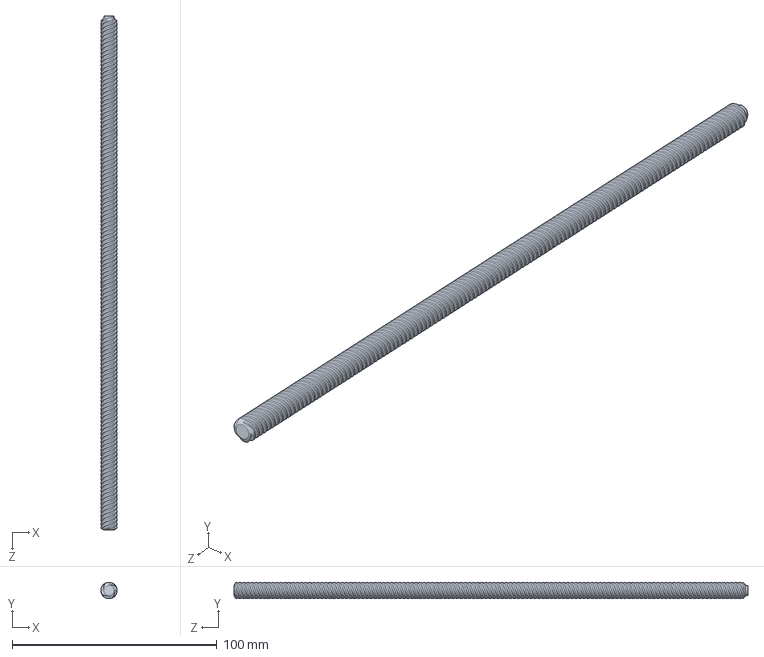
[picture p39: CAD file, 2023-12-27]
new_sw/tr8丝杠z轴.SLDPRT
8.00 x 8.00 x 251.0 mm
