alextomdog/3d-printer/new_sw/1515-320.SLDPRT

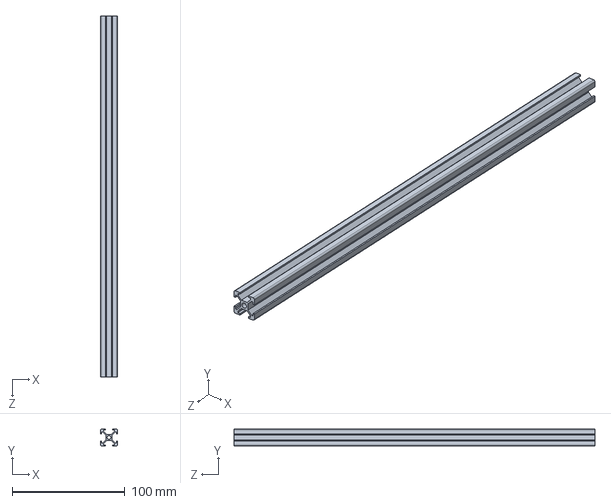
[picture p40: CAD file, 2023-12-27]
new_sw/1515-320.SLDPRT
15.0 x 15.0 x 320.0 mm
