alextomdog/3d-printer/new_sw/边角固定.SLDPRT

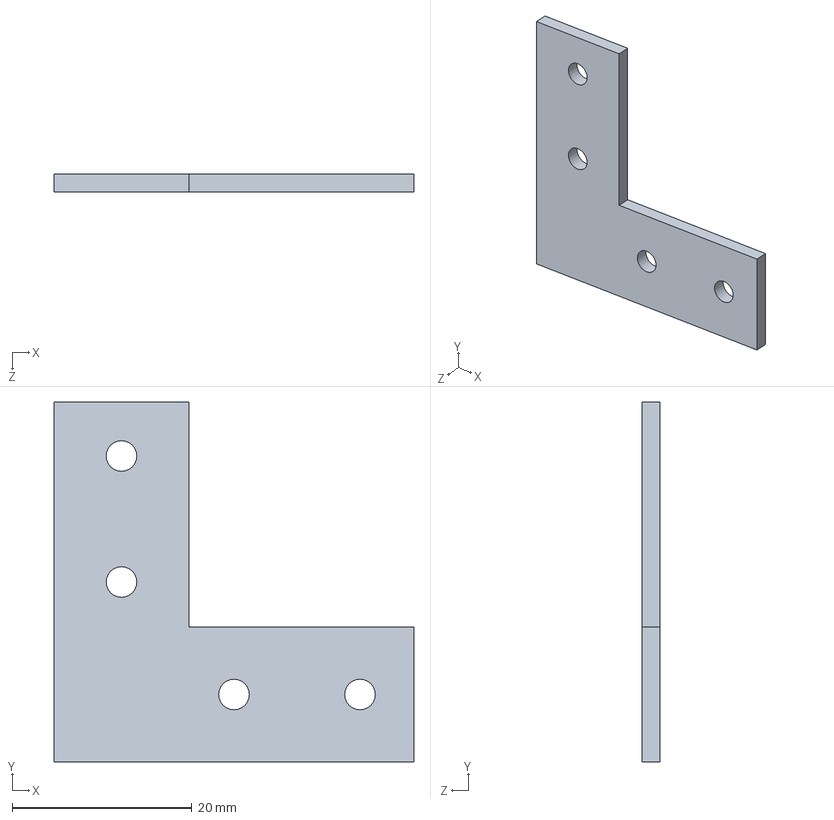
[picture p41: CAD file, 2023-12-27]
new_sw/边角固定.SLDPRT
40.0 x 40.0 x 2.00 mm
