alextomdog/3d-printer/new_sw/fixSteperPanel.SLDPRT

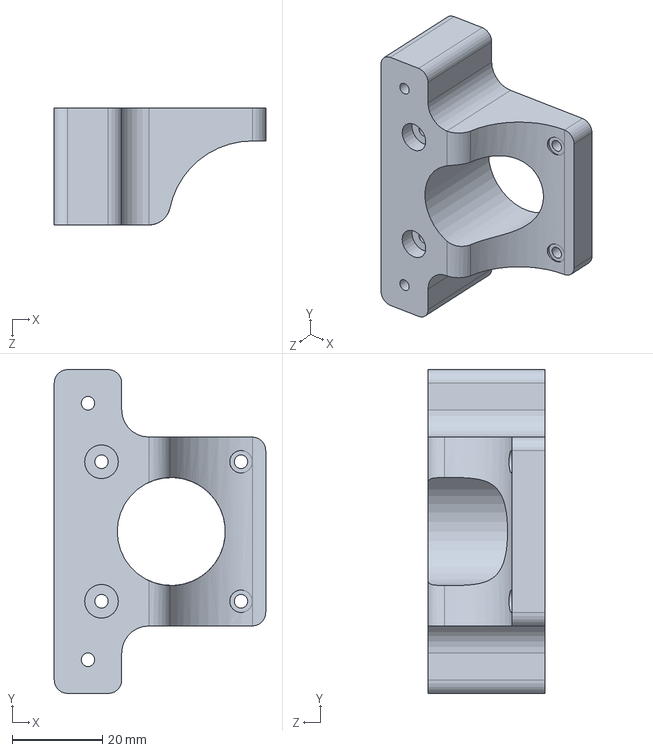
[picture p42: CAD file, 2023-12-27]
new_sw/fixSteperPanel.SLDPRT
47.0 x 72.0 x 26.0 mm
