alextomdog/3d-printer/new_sw/step-motor-47.SLDPRT

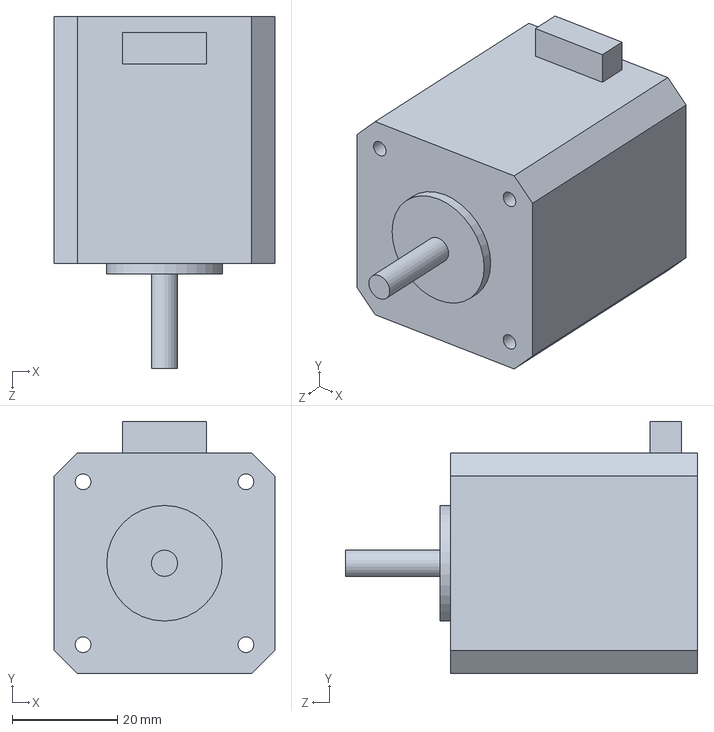
[picture p43: CAD file, 2023-12-27]
new_sw/step-motor-47.SLDPRT
42.0 x 48.0 x 67.0 mm
