alextomdog/3d-printer/new_sw/热床底部框架连接.SLDPRT

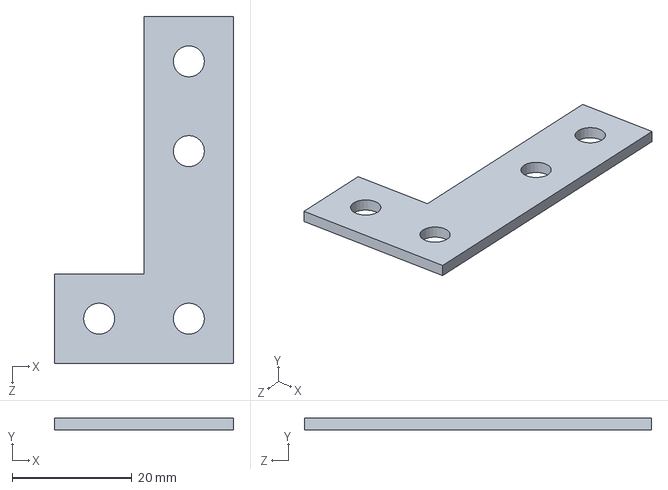
[picture p44: CAD file, 2023-12-27]
new_sw/热床底部框架连接.SLDPRT
30.0 x 2.00 x 58.0 mm
