alextomdog/3d-printer/new_sw/热床四边固定.SLDPRT

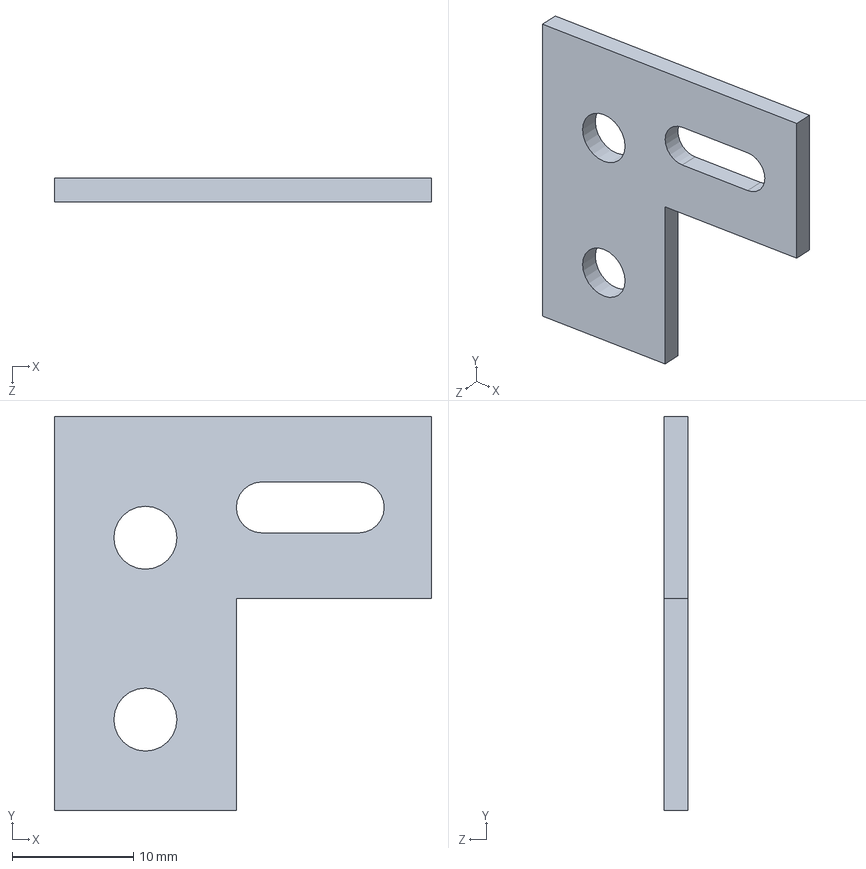
[picture p45: CAD file, 2023-12-27]
new_sw/热床四边固定.SLDPRT
31.1 x 32.5 x 2.00 mm
