alextomdog/3d-printer/new_sw/MGN9滑块.SLDPRT

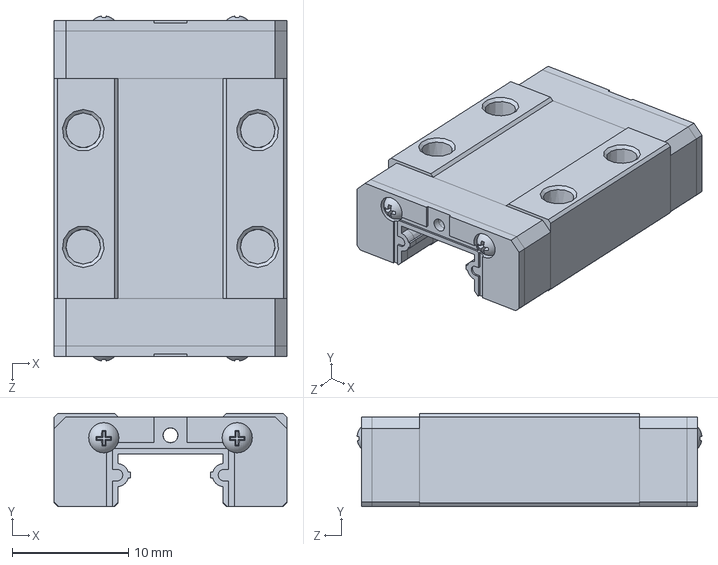
[picture p46: CAD file, 2023-12-27]
new_sw/MGN9滑块.SLDPRT
20.0 x 8.00 x 29.7 mm
