alextomdog/3d-printer/new_sw/喷头限位器固定.SLDPRT

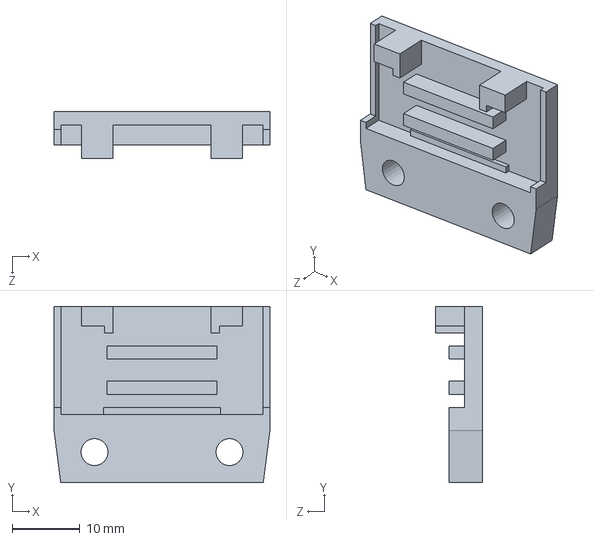
[picture p47: CAD file, 2023-12-27]
new_sw/喷头限位器固定.SLDPRT
32.0 x 26.1 x 7.00 mm
