alextomdog/3d-printer/new_sw/z光轴固定.SLDPRT

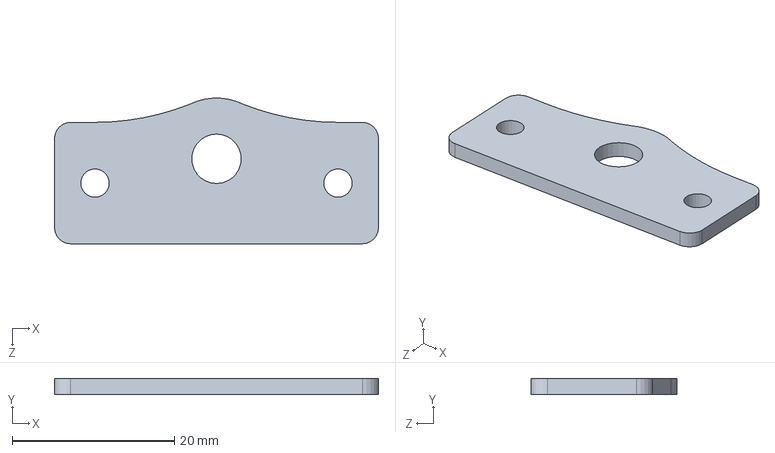
[picture p48: CAD file, 2023-12-27]
new_sw/z光轴固定.SLDPRT
40.0 x 2.00 x 18.0 mm
