alextomdog/3d-printer/new_sw/1515-285.SLDPRT

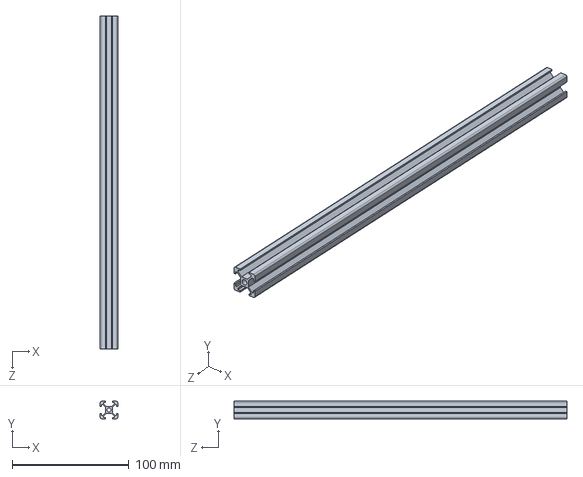
[picture p49: CAD file, 2023-12-27]
new_sw/1515-285.SLDPRT
15.0 x 15.0 x 285.0 mm
