alextomdog/3d-printer/new_sw/挤出机支架固定片.SLDPRT

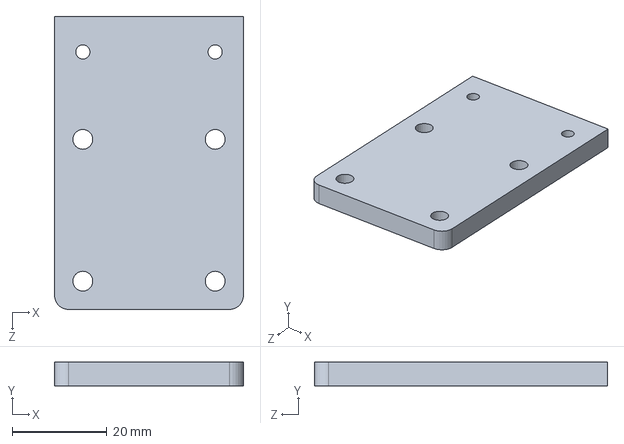
[picture p50: CAD file, 2023-12-27]
new_sw/挤出机支架固定片.SLDPRT
40.0 x 5.00 x 62.0 mm
