alextomdog/3d-printer/new_sw/1515-293.SLDPRT

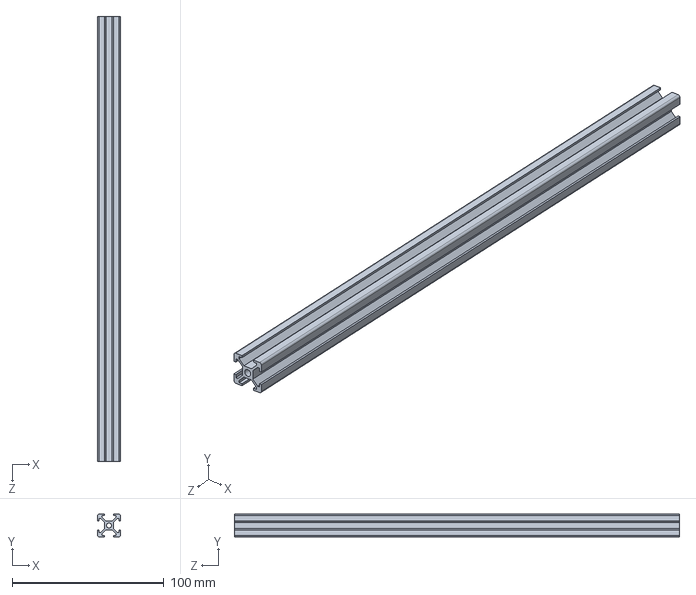
[picture p51: CAD file, 2023-12-27]
new_sw/1515-293.SLDPRT
15.0 x 15.0 x 293.0 mm
