alextomdog/3d-printer/new_sw/MK8 Red Extruder Bowden.SLDASM

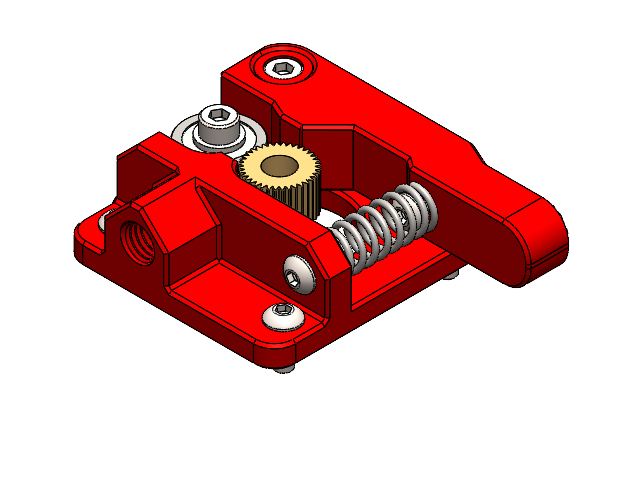
[picture p53: CAD file, 2023-12-27]
new_sw/MK8 Red Extruder Bowden.SLDASM
Extrusor - P1 -MK8^MK8 Red Extruder Bowden
Extrusor - P2 -MK8^MK8 Red Extruder Bowden
Extrusor - P3 -MK8^MK8 Red Extruder Bowden
Toothed Filament Feed^MK8 Red Extruder Bowden
U604zz^MK8 Red Extruder Bowden
Mola^MK8 Red Extruder Bowden
flat washer narrow_am x 2
socket head cap screw_am x 2
socket countersunk head screw_am
socket button head cap screw_am x 4
socket set screw cone point_am x 2
