alextomdog/3d-printer/new_sw/火山喷头V6.SLDASM

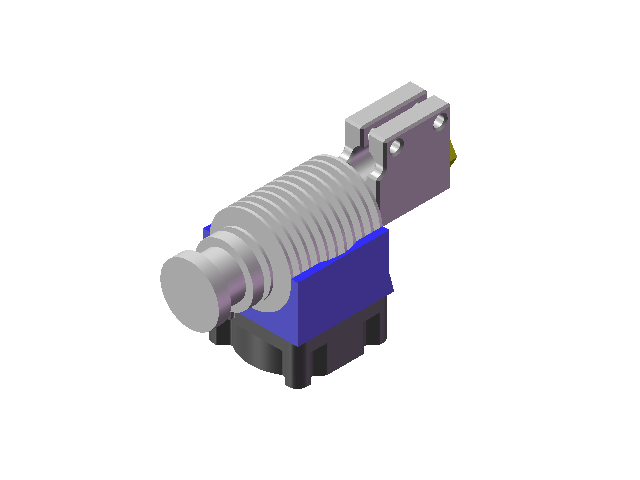
[picture p54: CAD file, 2023-12-27]
new_sw/火山喷头V6.SLDASM
Body.step_1.STEP
Blades.step_1.STEP
Bloco Aquecedor_1.STEP
Dissipador_1.STEP
Bico 0.4mm_1.STEP
Tubo conector_1.STEP
Acoplador da ventoinha_1.STEP
