alextomdog/3d-printer/new_sw/H惰轮可移动导向.SLDASM

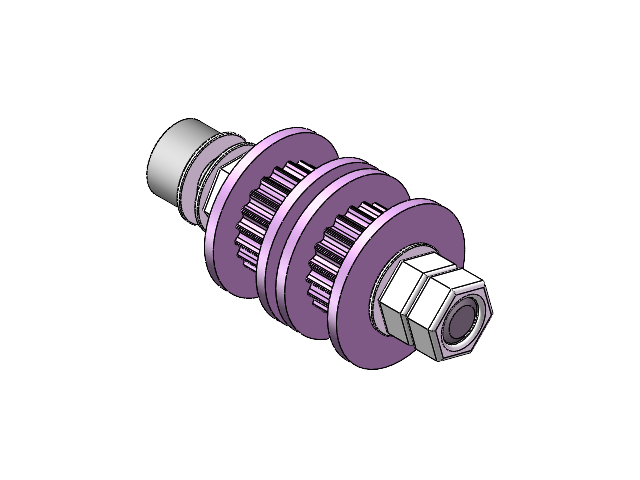
[picture p55: CAD file, 2023-12-27]
new_sw/H惰轮可移动导向.SLDASM
GB／T70．1-2000内六角圆柱头螺钉M5×35
M5-10-05垫圈 x 5
M5螺母8-5-3_9 x 3
H型号惰轮20齿带宽6内孔5厚度85带齿 x 2
