alextomdog/3d-printer/(list of files, cad)

Other CAD files:
new_sw/cadFiles/42-步进电机固定片.DWG
new_sw/cadFiles/法兰螺母-热床连接.DWG
new_sw/cadFiles/asside.DWG
new_sw/cadFiles/top1.DWG
new_sw/vocano/bottom1.SLDPRT
new_sw/cadFiles/汇总.dwg
new_sw/cadFiles/bottom2.DWG
new_sw/vocano/bottom2.SLDPRT
new_sw/水平限位开关固定器 - 镜像 - 副本.SLDPRT
new_sw/H型号惰轮20齿带宽6内孔5厚度85.SLDPRT
new_sw/MGN9滑轨-285.SLDPRT
new_sw/M5-10-05垫圈.SLDPRT
new_sw/cadFiles/42-步进电机固定片-xy.DWG
new_sw/cadFiles/z光轴固定.DWG
new_sw/cadFiles/同步带卡住零件.DWG
new_sw/cadFiles/挤出机支架固定片.DWG
new_sw/cadFiles/滑动连接器xy.DWG
new_sw/cadFiles/热床四边固定.DWG
new_sw/cadFiles/热床底部框架连接.DWG
new_sw/cadFiles/边角固定.DWG
new_sw/cadFiles/边角支架固定H型号惰轮.DWG
