alextomdog/3d-printer/(commit log)

2023-12-27 optimize z axis
    optimum z axis , and waiting to optimize the corexy plane area
    [1515-200.SLDPRT, 1515-220.SLDPRT, 1515-285.SLDPRT, 1515-293.SLDPRT, 1515-320.SLDPRT, 42-步进电机固定片-xy.DWG, 42-步进电机固定片-xy.SLDPRT, 42-步进电机固定片.DWG]
2023-12-28 update z-axis version-1
    [rail_slider_1515_connection.SLDPRT, z-axis-with-slider.SLDASM, 丝杠法兰螺母-热床.SLDPRT, 打印机.SLDASM, 滑块-热床.SLDPRT]
2026-10-24 Add project docs, BOM summary and clean CAD backups
